JOCRIX/JRIX-KiCad-Schematic-symbols-and-Footprint-libraries/JRIX BGA 3D Models/TFBGA-324_P0.8mm_Body15x15mm.step

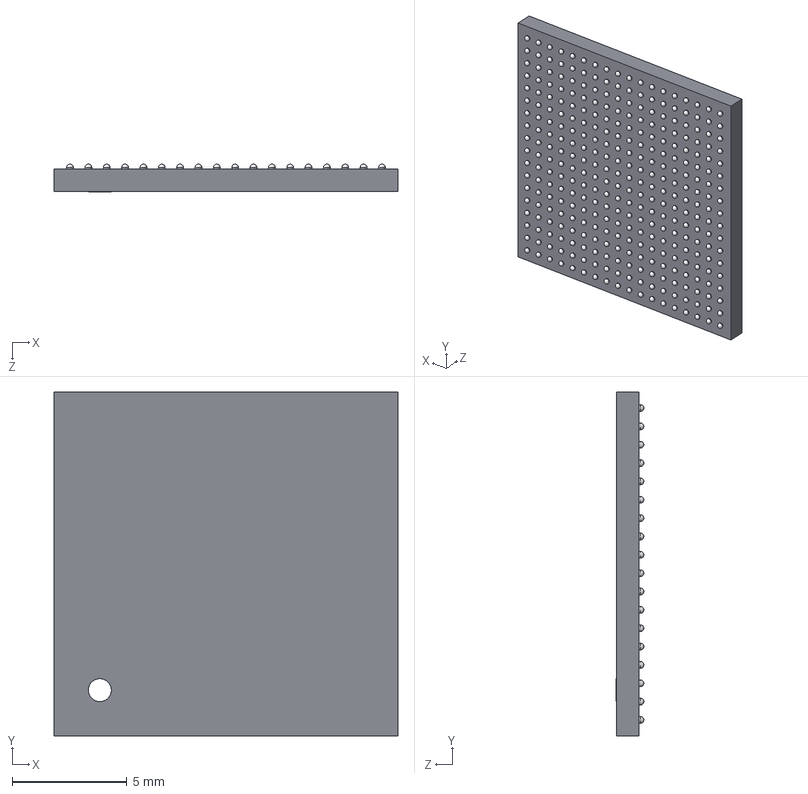
[picture p1: CAD file, 2025-07-26]
JRIX BGA 3D Models/TFBGA-324_P0.8mm_Body15x15mm.step
15.0 x 15.0 x 1.21 mm
Extruded_2
