JOCRIX/JRIX-KiCad-Schematic-symbols-and-Footprint-libraries/JRIX Capacitor SMD 3D Models/C_2x1.25x1.25_GRM21BZ71C106KE15K.stp

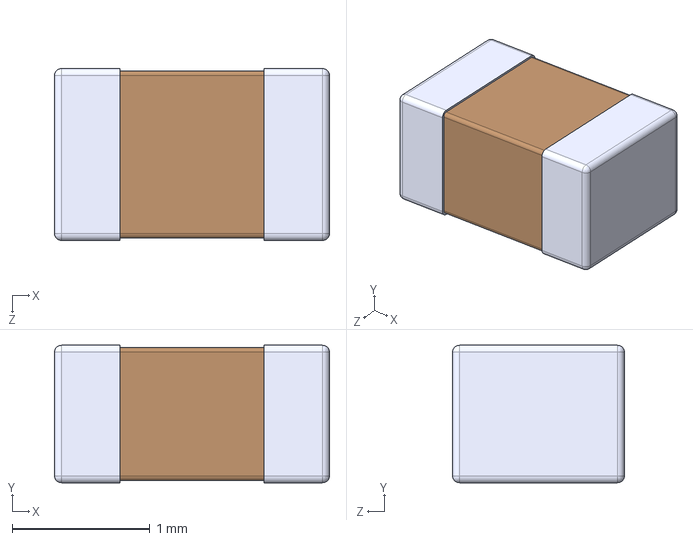
[picture p2: CAD file, 2025-07-29]
JRIX Capacitor SMD 3D Models/C_2x1.25x1.25_GRM21BZ71C106KE15K.stp
2.00 x 1.00 x 1.25 mm
