JOCRIX/JRIX-KiCad-Schematic-symbols-and-Footprint-libraries/JRIX Common-Mode Choke 3D Models/ACM9070-701-2PL-TL01.stp

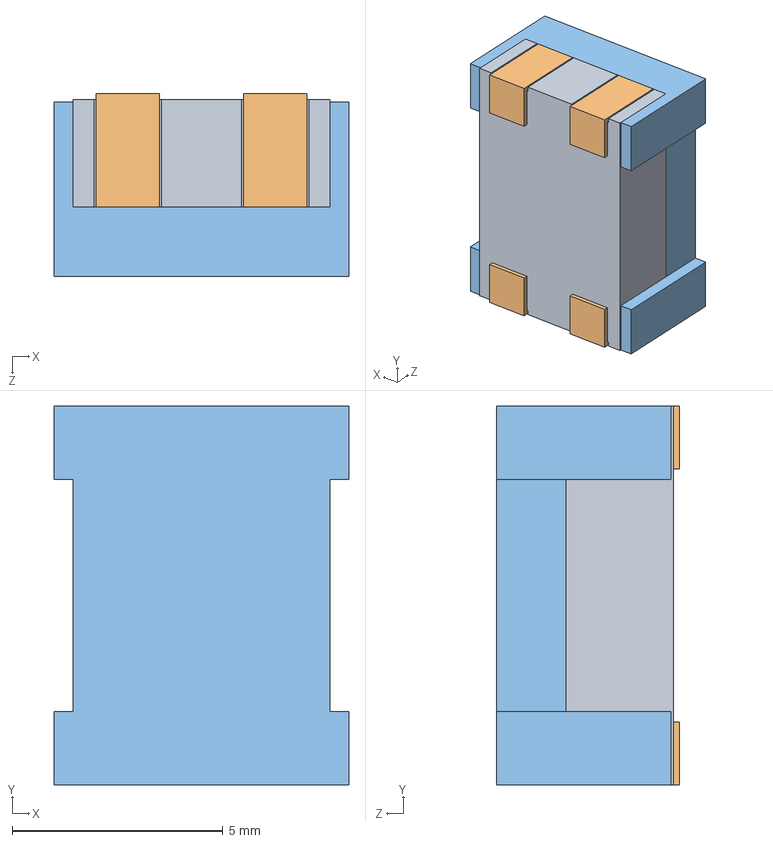
[picture p3: CAD file, 2025-07-09]
JRIX Common-Mode Choke 3D Models/ACM9070-701-2PL-TL01.stp
7.00 x 9.00 x 4.35 mm
ACM90Vコアblock(typ size)
ACM90V端子block(typ size) x 4
ACM90Vカバblock(typ size)
