JOCRIX/JRIX-KiCad-Schematic-symbols-and-Footprint-libraries/JRIX Connector 3D Models/CONBNC001.stp

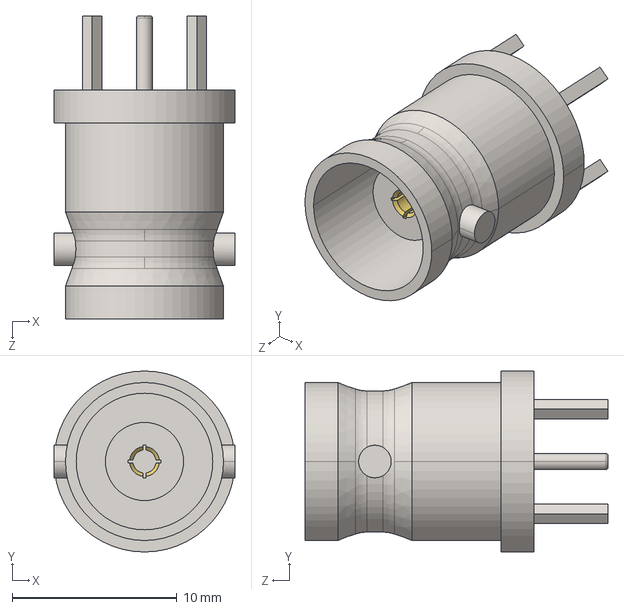
[picture p4: CAD file, 2025-07-27]
JRIX Connector 3D Models/CONBNC001.stp
11.0 x 11.0 x 18.4 mm
