JOCRIX/JRIX-KiCad-Schematic-symbols-and-Footprint-libraries/JRIX DFN SMD 3D Models/22-WFDFN-ExposedPad_22DFN_6x3_AnalogDevices.step

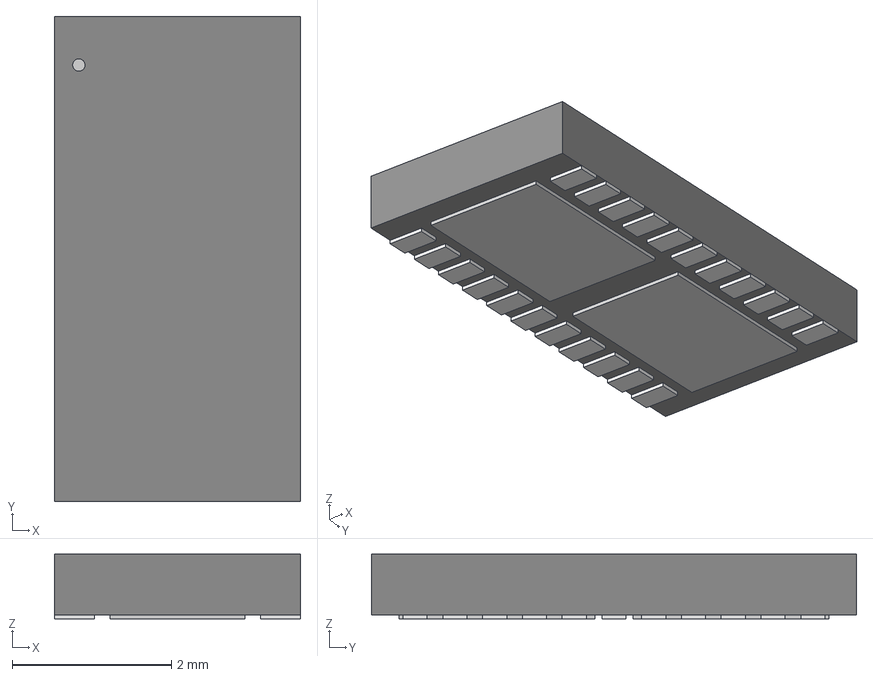
[picture p5: CAD file, 2025-07-28]
JRIX DFN SMD 3D Models/22-WFDFN-ExposedPad_22DFN_6x3_AnalogDevices.step
3.10 x 6.10 x 0.815 mm
