JOCRIX/JRIX-KiCad-Schematic-symbols-and-Footprint-libraries/JRIX Diode 3D Models/infineon-sg-wll-2-11-3d-01-stp-package-en.stp

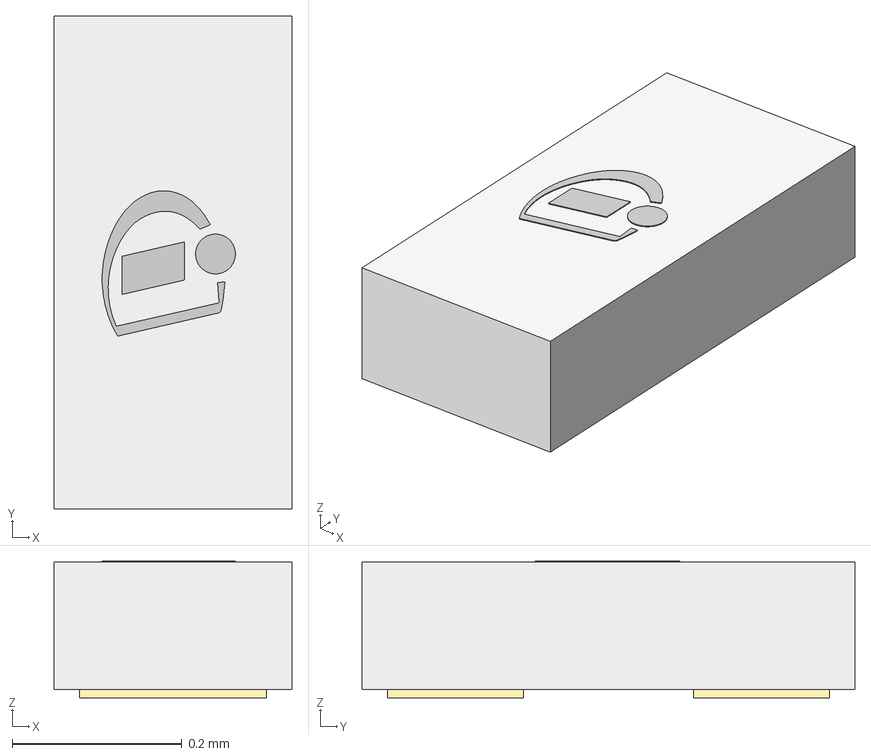
[picture p6: CAD file, 2025-07-27]
JRIX Diode 3D Models/infineon-sg-wll-2-11-3d-01-stp-package-en.stp
0.28 x 0.58 x 0.161 mm
