JOCRIX/JRIX-KiCad-Schematic-symbols-and-Footprint-libraries/JRIX Ferrite Beat 3D Models/FB_0805_2x1.25x0.85_MPZ2012S221AT000.stp

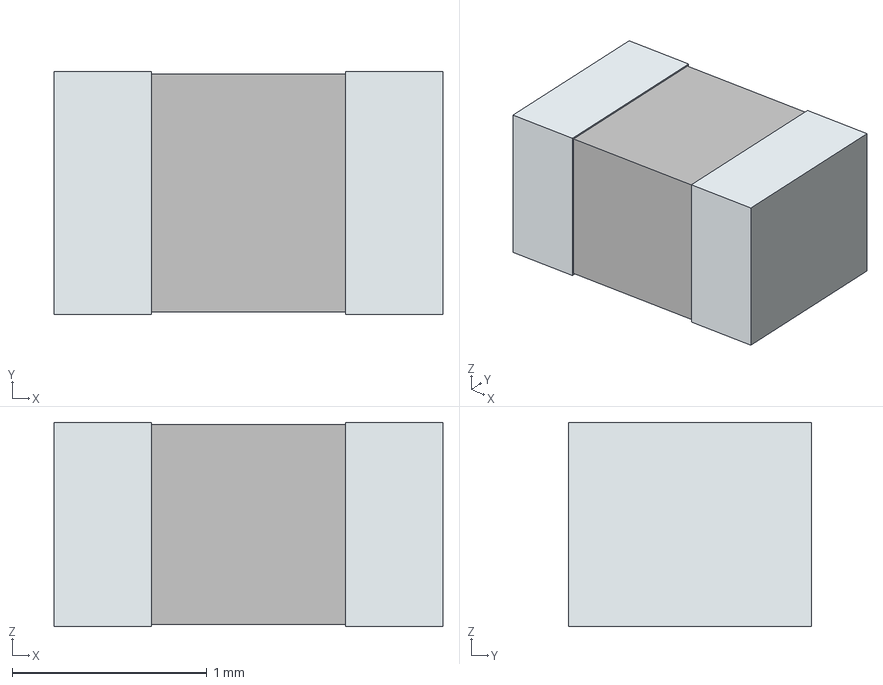
[picture p7: CAD file, 2025-07-13]
JRIX Ferrite Beat 3D Models/FB_0805_2x1.25x0.85_MPZ2012S221AT000.stp
2.00 x 1.25 x 1.05 mm
term1
term2
