JOCRIX/JRIX-KiCad-Schematic-symbols-and-Footprint-libraries/JRIX FPGA 3D Models/CMODS7.step

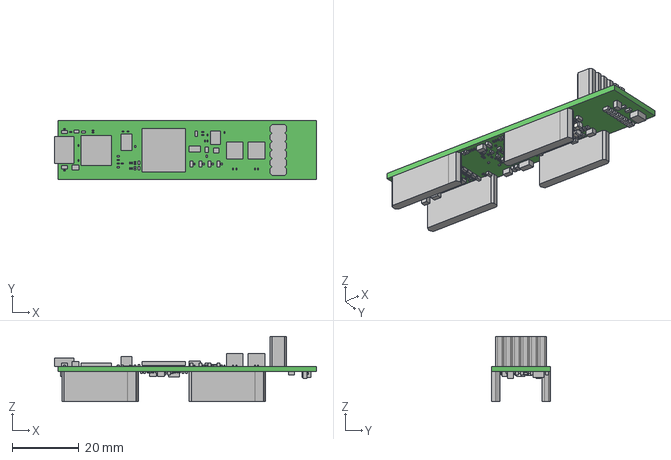
[picture p8: CAD file, 2024-12-05]
JRIX FPGA 3D Models/CMODS7.step
78.4 x 17.8 x 19.6 mm
Board
Extruded x 243
