JOCRIX/JRIX-KiCad-Schematic-symbols-and-Footprint-libraries/JRIX Inductor SMD 3D Models/L_ASPI-4030S-1R0N-T.stp

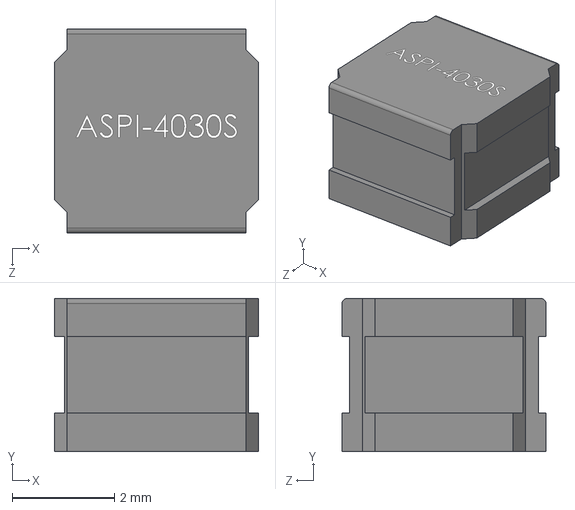
[picture p9: CAD file, 2025-07-11]
JRIX Inductor SMD 3D Models/L_ASPI-4030S-1R0N-T.stp
4.00 x 3.00 x 4.00 mm
