JOCRIX/JRIX-KiCad-Schematic-symbols-and-Footprint-libraries/JRIX Inductor THT 3D Models/AIUR-15-102K.step

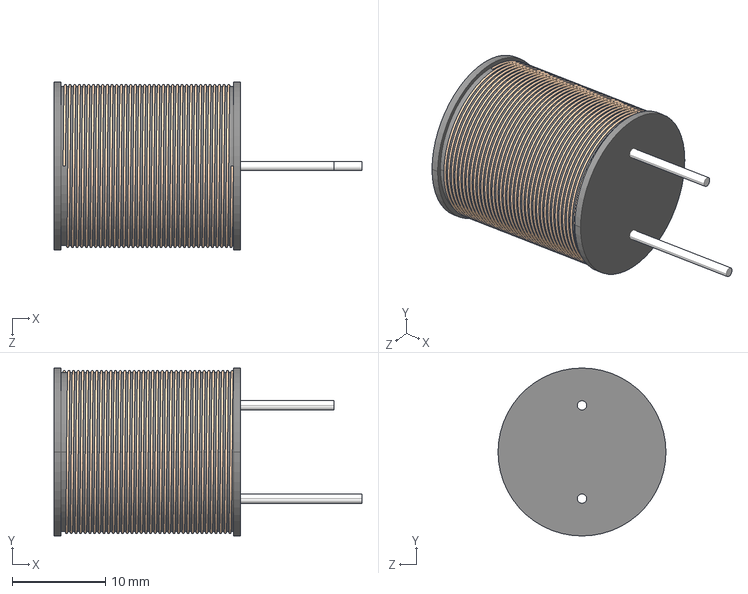
[picture p10: CAD file, 2024-12-03]
JRIX Inductor THT 3D Models/AIUR-15-102K.step
33.0 x 18.0 x 18.0 mm
