JOCRIX/JRIX-KiCad-Schematic-symbols-and-Footprint-libraries/JRIX LED 3D Models/AP1608SURCK.stp

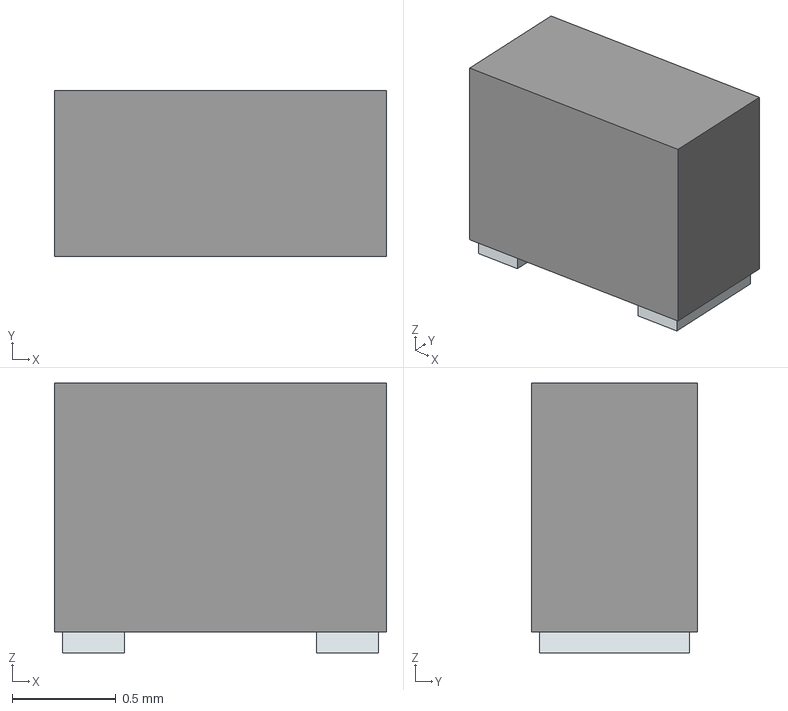
[picture p11: CAD file, 2025-07-08]
JRIX LED 3D Models/AP1608SURCK.stp
1.60 x 0.8 x 1.30 mm
Pins
