JOCRIX/JRIX-KiCad-Schematic-symbols-and-Footprint-libraries/JRIX QFN 3D Models/VFQFN-32_ExposedPad_CSP_32-LFCSP_5x5.step

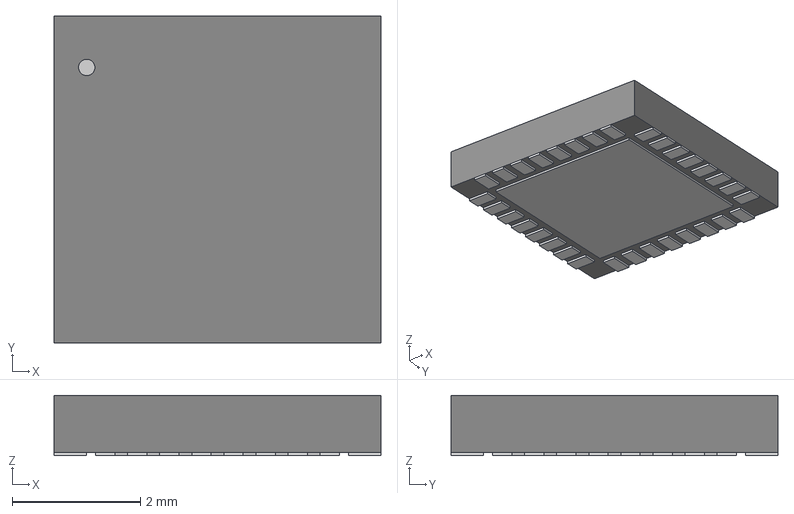
[picture p12: CAD file, 2025-07-28]
JRIX QFN 3D Models/VFQFN-32_ExposedPad_CSP_32-LFCSP_5x5.step
5.11 x 5.11 x 0.942 mm
