JOCRIX/JRIX-KiCad-Schematic-symbols-and-Footprint-libraries/JRIX Relay 3D Models/RY-12W-K.step

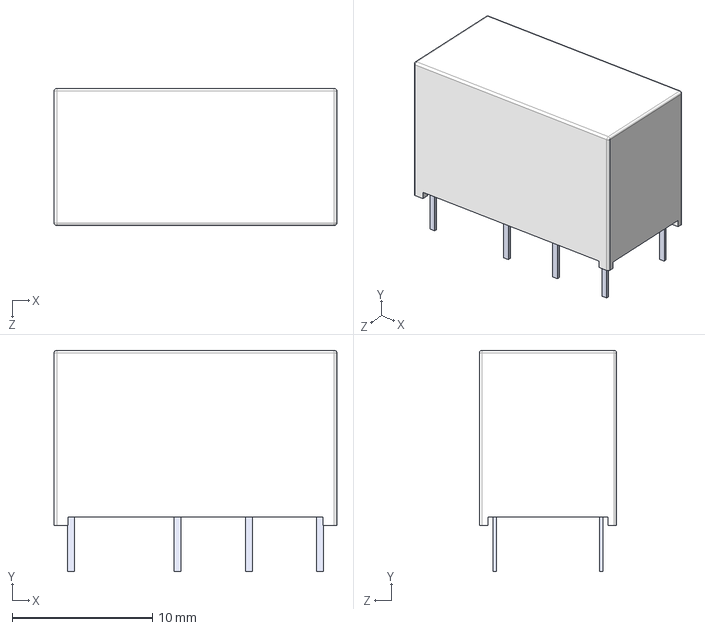
[picture p13: CAD file, 2024-12-03]
JRIX Relay 3D Models/RY-12W-K.step
20.2 x 15.8 x 9.80 mm
