JOCRIX/JRIX-KiCad-Schematic-symbols-and-Footprint-libraries/JRIX Resistor 3D Models/R_ThinFilm_0805_Vishay-MCU.stp

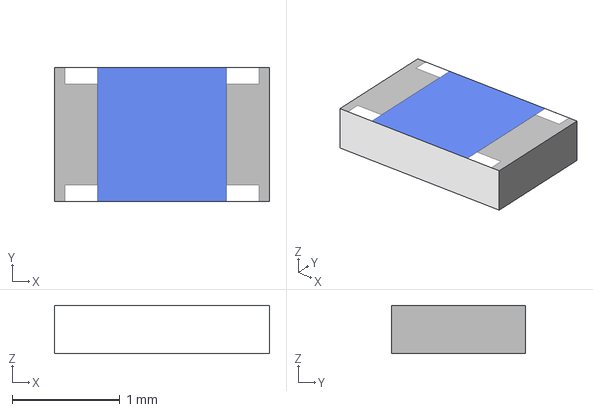
[picture p14: CAD file, 2025-07-27]
JRIX Resistor 3D Models/R_ThinFilm_0805_Vishay-MCU.stp
2.00 x 1.25 x 0.45 mm
