JOCRIX/JRIX-KiCad-Schematic-symbols-and-Footprint-libraries/JRIX SOP 3D Models/SSOP-28_5.3x10.2x1.8.iges

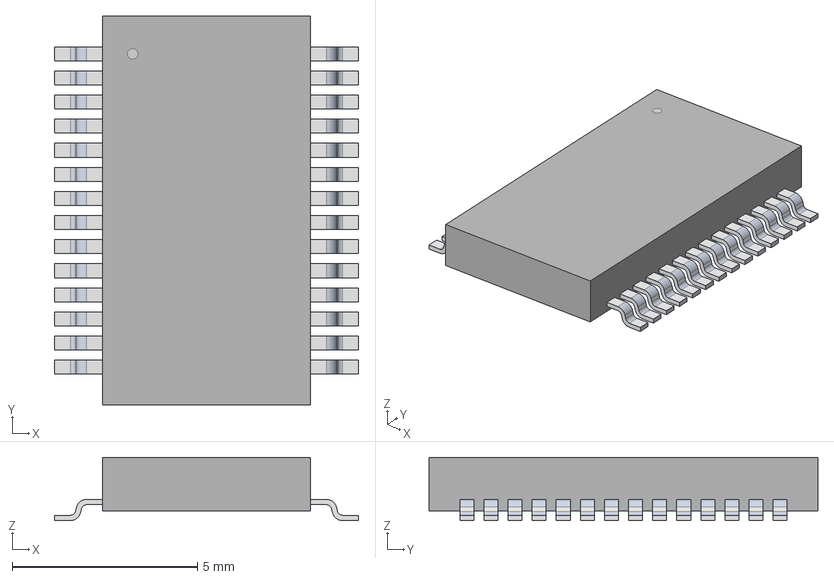
[picture p15: CAD file, 2025-07-29]
JRIX SOP 3D Models/SSOP-28_5.3x10.2x1.8.iges
8.20 x 10.5 x 1.70 mm
