JOCRIX/JRIX-KiCad-Schematic-symbols-and-Footprint-libraries/JRIX SOT SMD 3D Models/SOT-23-5_SC-74A_SOT-753_RJ_5_ADI.step

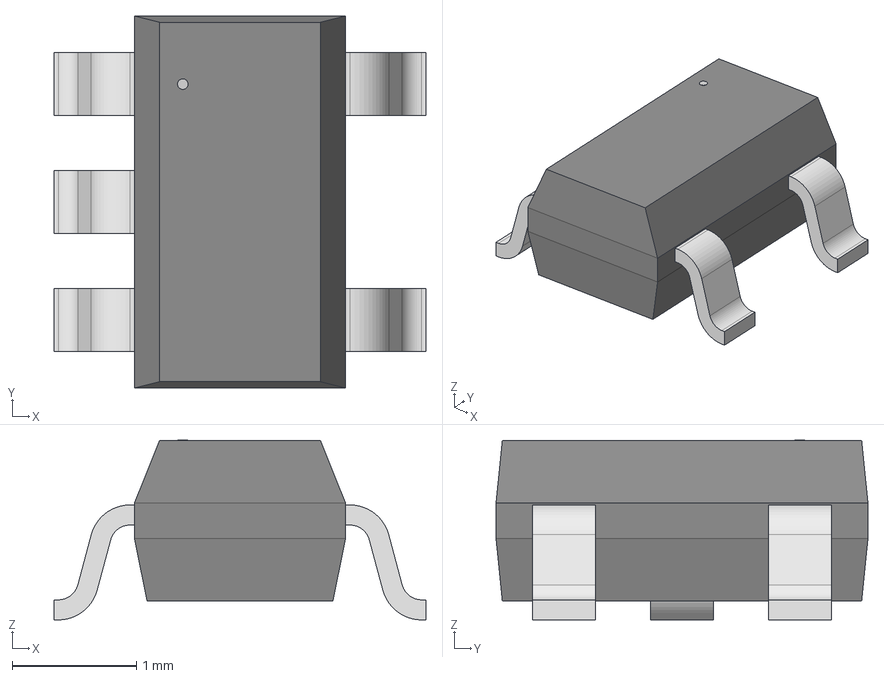
[picture p16: CAD file, 2025-07-29]
JRIX SOT SMD 3D Models/SOT-23-5_SC-74A_SOT-753_RJ_5_ADI.step
3.00 x 3.00 x 1.45 mm
