JOCRIX/JRIX-KiCad-Schematic-symbols-and-Footprint-libraries/JRIX Switches 3D Models/C&K_PTS647-Series_4.5x4.5x7_PTS647SK70SMTR2N_LFS.stp

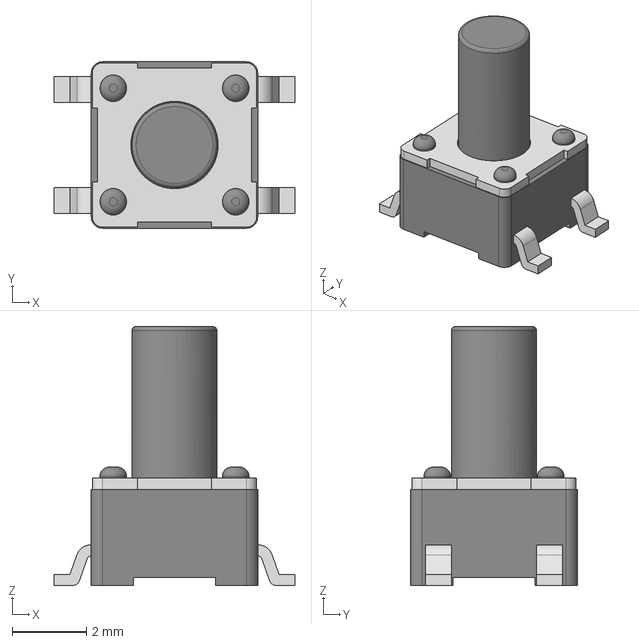
[picture p17: CAD file, 2025-07-27]
JRIX Switches 3D Models/C&K_PTS647-Series_4.5x4.5x7_PTS647SK70SMTR2N_LFS.stp
6.50 x 4.50 x 7.00 mm
