JOCRIX/JRIX-KiCad-Schematic-symbols-and-Footprint-libraries/JRIX Terminal Blocks 3D Models/TB006-508-02BE.STEP

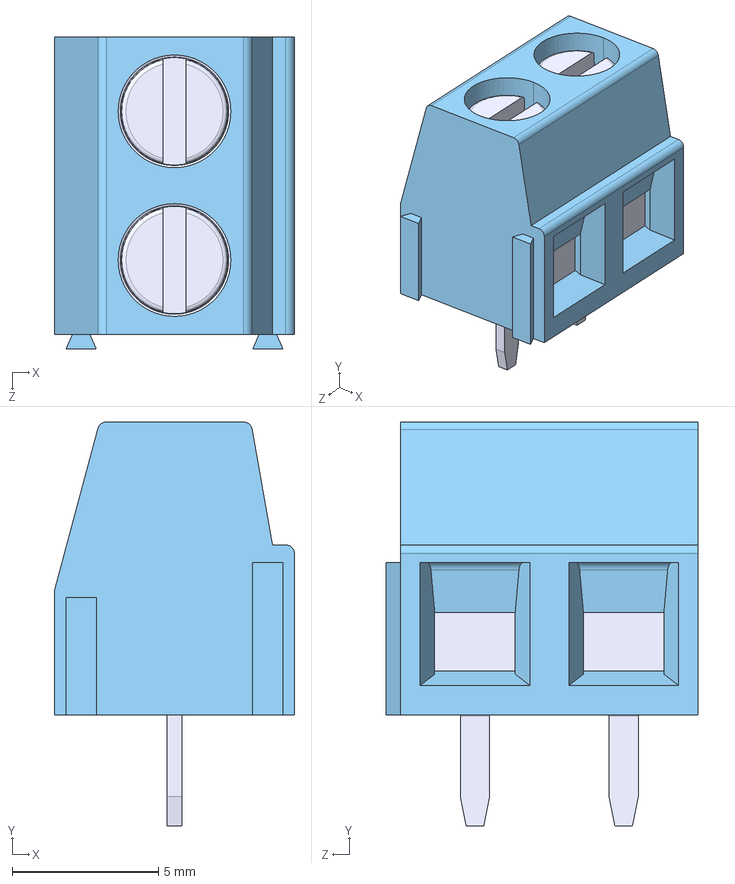
[picture p18: CAD file, 2025-07-27]
JRIX Terminal Blocks 3D Models/TB006-508-02BE.STEP
8.20 x 13.8 x 10.7 mm
