JOCRIX/JRIX-KiCad-Schematic-symbols-and-Footprint-libraries/JRIX XO 3D Models/SIT9501AI-02A1-2510-125.000000.stp

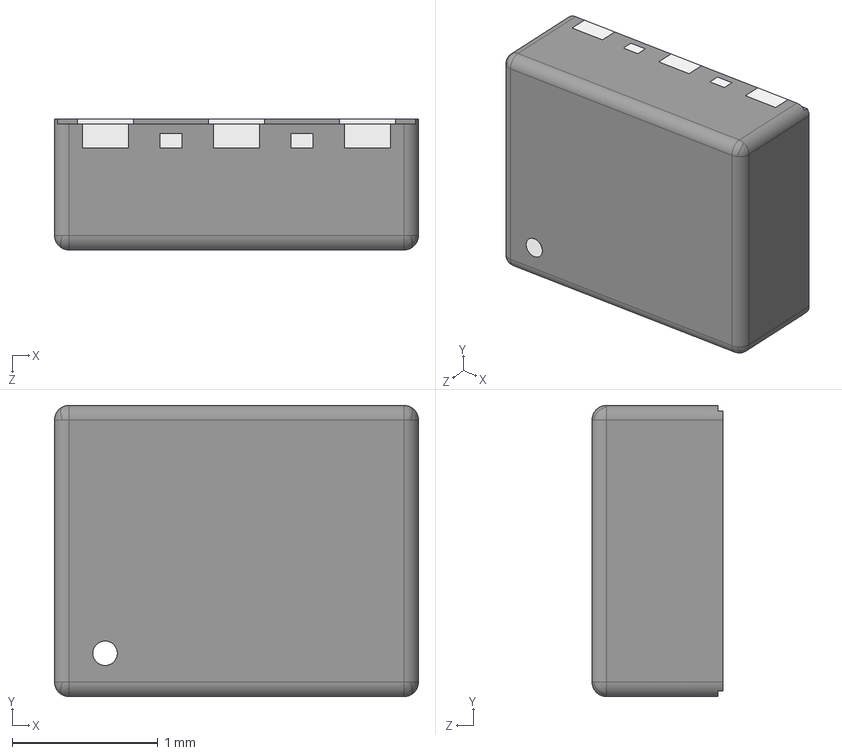
[picture p19: CAD file, 2025-07-08]
JRIX XO 3D Models/SIT9501AI-02A1-2510-125.000000.stp
2.50 x 2.00 x 0.902 mm
