JOCRIX/JRIX-KiCad-Schematic-symbols-and-Footprint-libraries/JRIX BGA 3D Models/FBGA-48_6x10_Layout-6x8_P0.75_AS7CW2M16-10BIN.stp

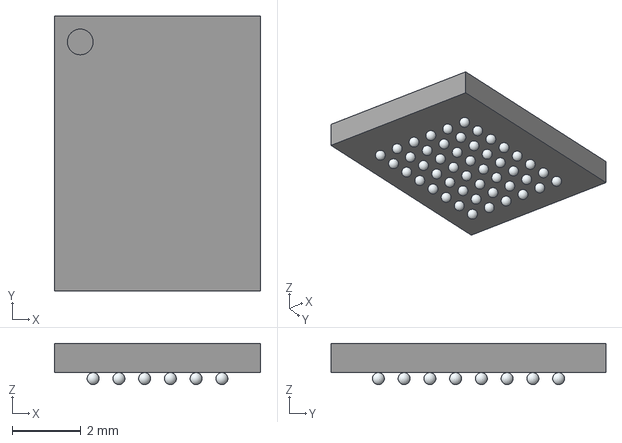
[picture p20: CAD file, 2025-07-26]
JRIX BGA 3D Models/FBGA-48_6x10_Layout-6x8_P0.75_AS7CW2M16-10BIN.stp
6.00 x 8.00 x 1.20 mm
