JOCRIX/JRIX-KiCad-Schematic-symbols-and-Footprint-libraries/JRIX Capacitor SMD 3D Models/C_1x0.5x0.5604023A1R2BAT2A.stp

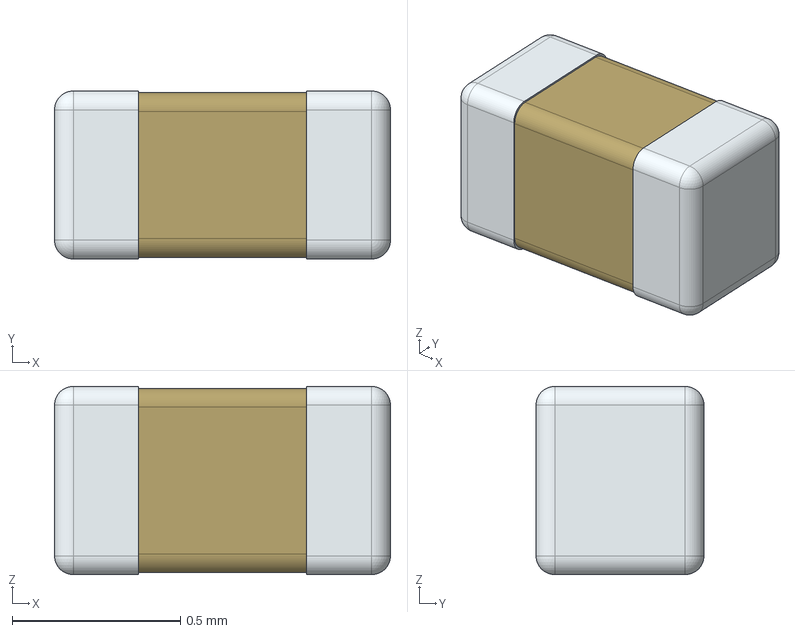
[picture p21: CAD file, 2025-07-29]
JRIX Capacitor SMD 3D Models/C_1x0.5x0.5604023A1R2BAT2A.stp
1.00 x 0.5 x 0.56 mm
