JOCRIX/JRIX-KiCad-Schematic-symbols-and-Footprint-libraries/JRIX DFN SMD 3D Models/DFN-10_LT3042EDD#PBF.stp

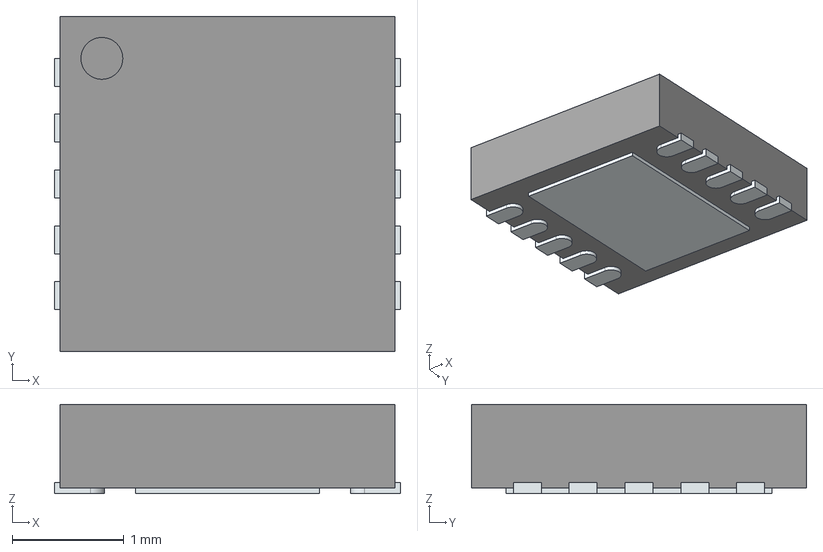
[picture p22: CAD file, 2025-07-13]
JRIX DFN SMD 3D Models/DFN-10_LT3042EDD#PBF.stp
3.10 x 3.00 x 0.8 mm
ThermalPin
PinsArrayLR
