JOCRIX/JRIX-KiCad-Schematic-symbols-and-Footprint-libraries/JRIX Diode 3D Models/SOD-882L_CFSH05-20L_TR_PBFREE.stp

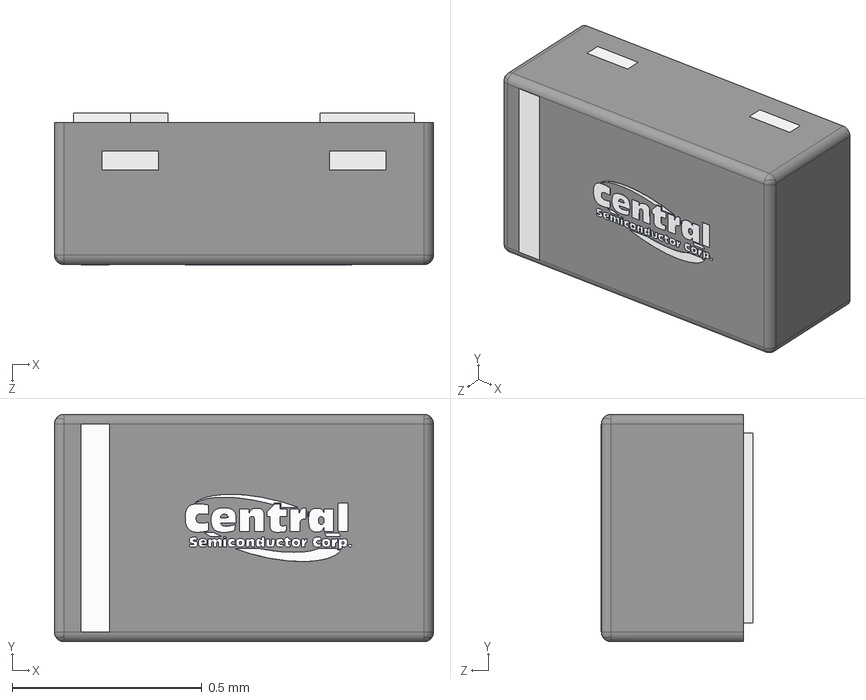
[picture p23: CAD file, 2025-07-09]
JRIX Diode 3D Models/SOD-882L_CFSH05-20L_TR_PBFREE.stp
1.00 x 0.6 x 0.401 mm
Package
Pads
Band
Logo
