JOCRIX/JRIX-KiCad-Schematic-symbols-and-Footprint-libraries/JRIX QFN 3D Models/QFN-14_TLV9064IRUCR.stp

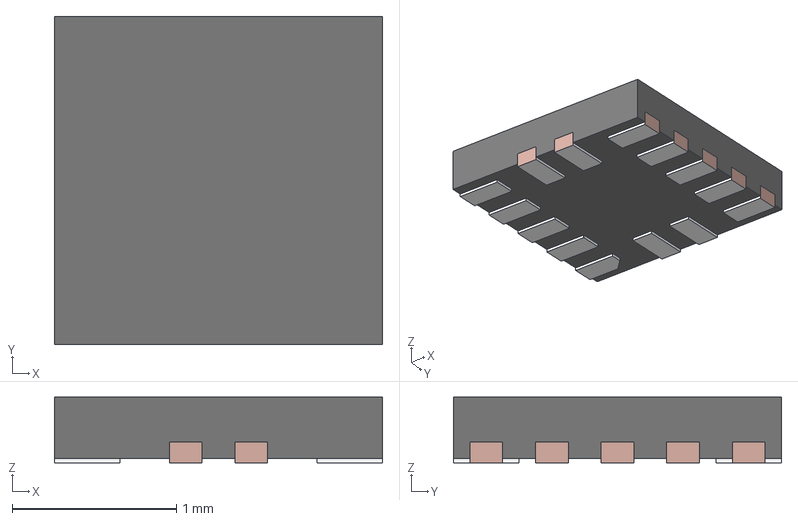
[picture p24: CAD file, 2025-07-27]
JRIX QFN 3D Models/QFN-14_TLV9064IRUCR.stp
2.00 x 2.00 x 0.4 mm
FRAME
