JOCRIX/JRIX-KiCad-Schematic-symbols-and-Footprint-libraries/JRIX Resistor 3D Models/R_ThinFilm_1x0.5x0.35_0402_TNPW040249K9BYEP.step

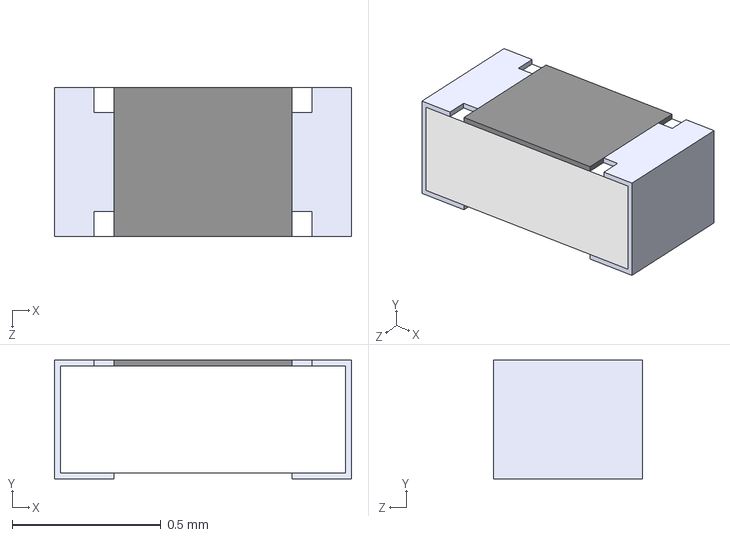
[picture p25: CAD file, 2025-07-27]
JRIX Resistor 3D Models/R_ThinFilm_1x0.5x0.35_0402_TNPW040249K9BYEP.step
1 x 0.4 x 0.5 mm
