JOCRIX/JRIX-KiCad-Schematic-symbols-and-Footprint-libraries/JRIX SOT SMD 3D Models/SOT-563-6_DRL0006A_1.6x1.2x0.6_Texas_Instruments.stp

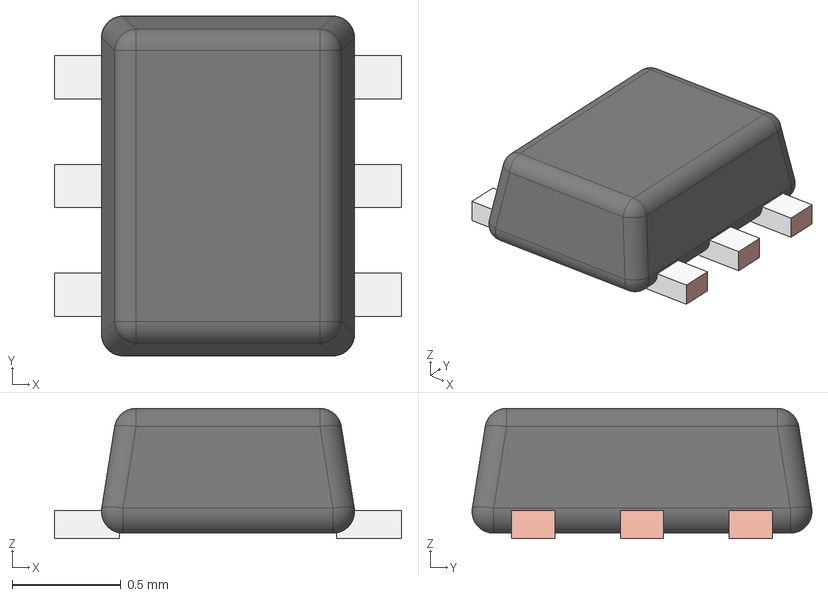
[picture p26: CAD file, 2025-07-09]
JRIX SOT SMD 3D Models/SOT-563-6_DRL0006A_1.6x1.2x0.6_Texas_Instruments.stp
1.60 x 1.57 x 0.6 mm
FRAME-DRL0006A
BODY-SOT
PIN1-ID
