JOCRIX/JRIX-KiCad-Schematic-symbols-and-Footprint-libraries/JRIX Capacitor SMD 3D Models/C_1.6x0.81x0.9_0603_1608_06035A250GAT2A.stp

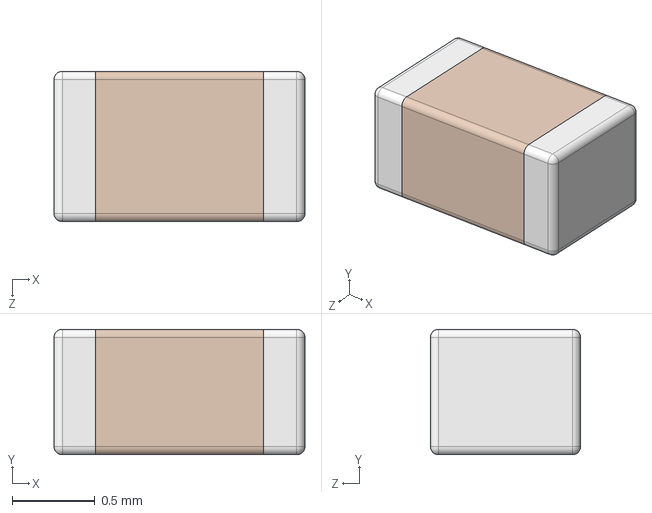
[picture p27: CAD file, 2025-07-28]
JRIX Capacitor SMD 3D Models/C_1.6x0.81x0.9_0603_1608_06035A250GAT2A.stp
1.52 x 0.76 x 0.91 mm
