JOCRIX/JRIX-KiCad-Schematic-symbols-and-Footprint-libraries/JRIX DFN SMD 3D Models/20-UDFDN_20-USON_TXB0108DQSR_4x2x0.5_Texas-Instruments.STEP

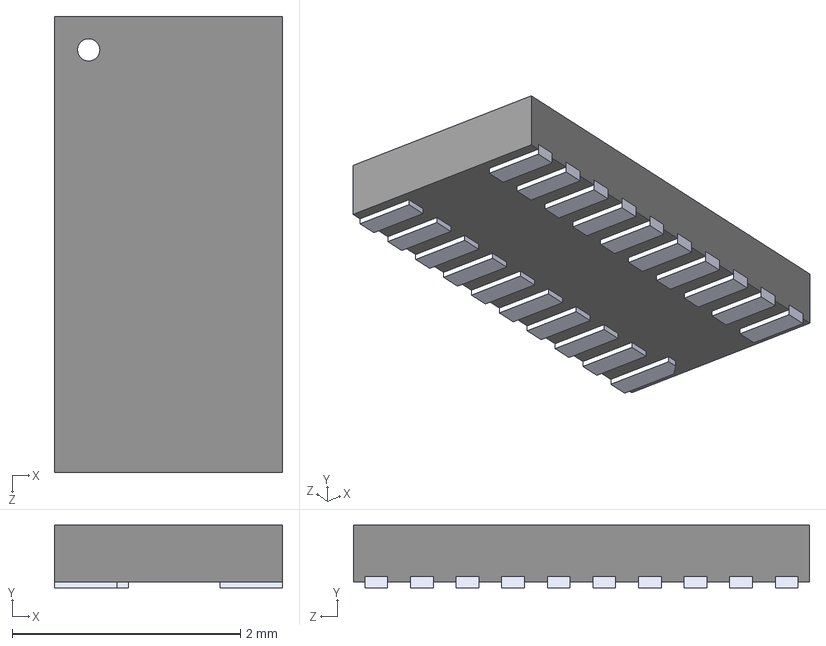
[picture p28: CAD file, 2025-07-09]
JRIX DFN SMD 3D Models/20-UDFDN_20-USON_TXB0108DQSR_4x2x0.5_Texas-Instruments.STEP
2.00 x 0.55 x 4.00 mm
