JOCRIX/JRIX-KiCad-Schematic-symbols-and-Footprint-libraries/JRIX Resistor 3D Models/R_ThinFilm_0402_Vishay-MCS.stp

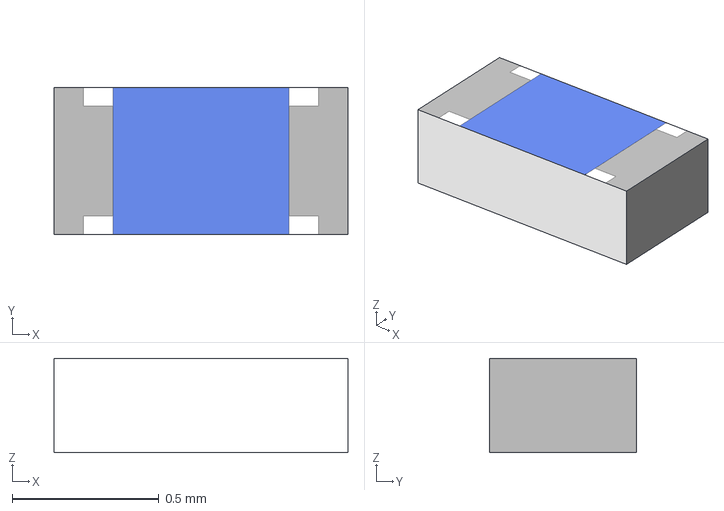
[picture p29: CAD file, 2025-07-27]
JRIX Resistor 3D Models/R_ThinFilm_0402_Vishay-MCS.stp
1.00 x 0.5 x 0.32 mm
