JOCRIX/JRIX-KiCad-Schematic-symbols-and-Footprint-libraries/JRIX SOT SMD 3D Models/SOT-553-5_SOT-5_Texas_Instruments_1.6x1.2x0.6.stp

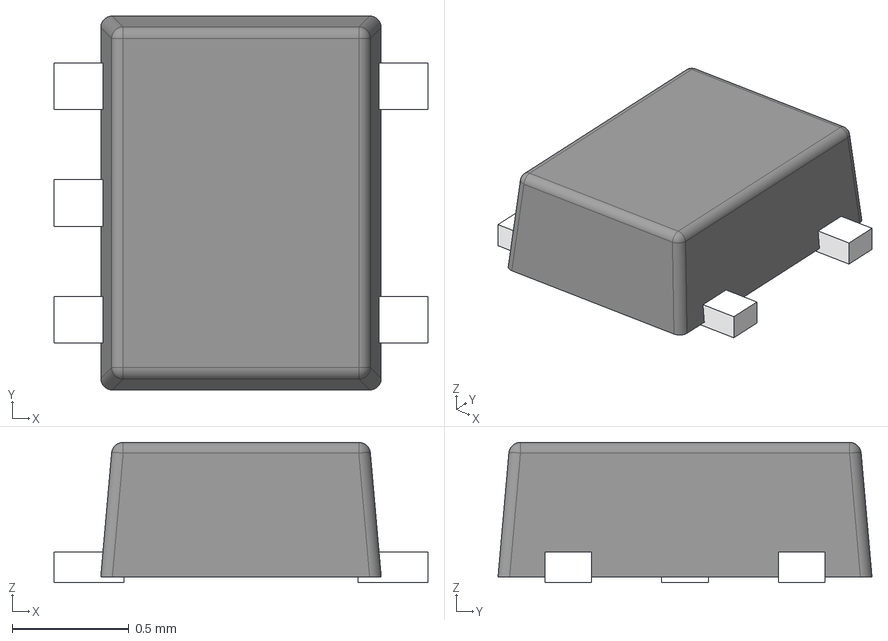
[picture p30: CAD file, 2025-07-09]
JRIX SOT SMD 3D Models/SOT-553-5_SOT-5_Texas_Instruments_1.6x1.2x0.6.stp
1.60 x 1.60 x 0.6 mm
FRAME-DRL0005A
BODY-SOT
PIN1-ID
