JOCRIX/JRIX-KiCad-Schematic-symbols-and-Footprint-libraries/JRIX QFN 3D Models/LTC2270IUP#PBF.stp

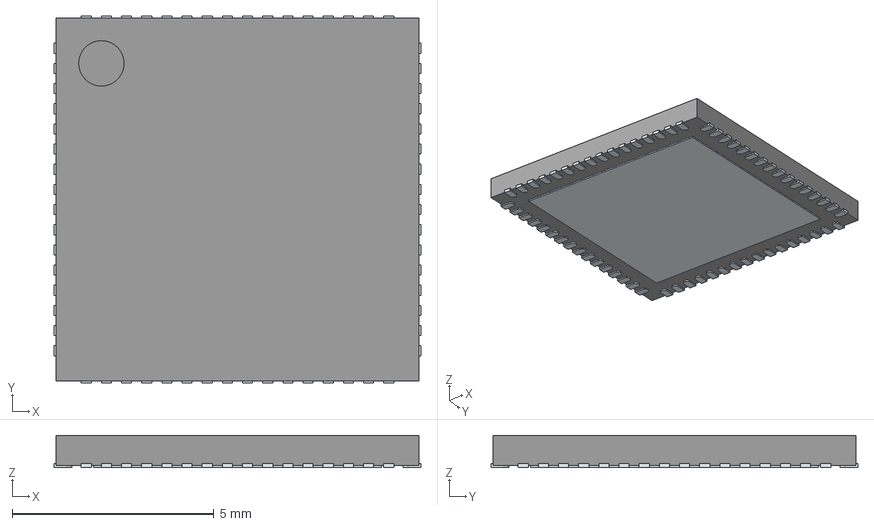
[picture p31: CAD file, 2025-07-13]
JRIX QFN 3D Models/LTC2270IUP#PBF.stp
9.10 x 9.10 x 0.8 mm
ThermalPin
PinsArrayLR
PinsArrayTB
