JOCRIX/JRIX-KiCad-Schematic-symbols-and-Footprint-libraries/JRIX Resistor 3D Models/R_ThinFilm_1206_Vishay-MCA.stp

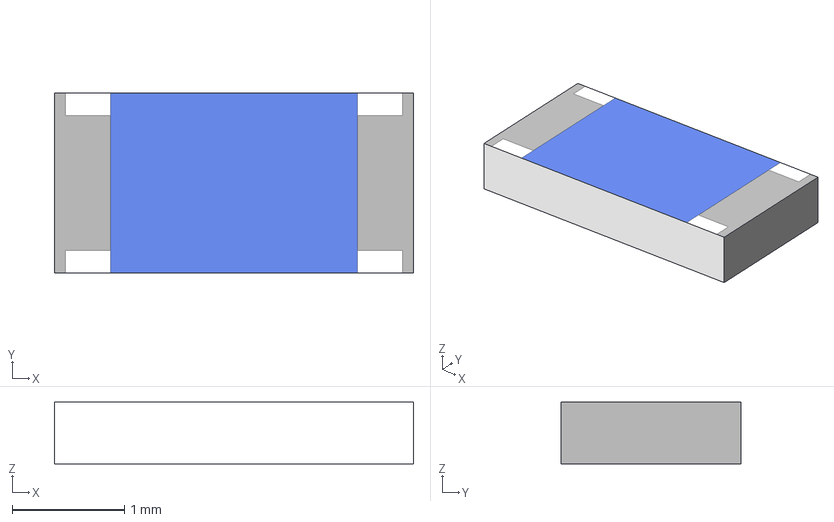
[picture p32: CAD file, 2025-07-27]
JRIX Resistor 3D Models/R_ThinFilm_1206_Vishay-MCA.stp
3.20 x 1.60 x 0.55 mm
