JOCRIX/JRIX-KiCad-Schematic-symbols-and-Footprint-libraries/JRIX Capacitor SMD 3D Models/C_Film_3.2x1.6x1.2_1206_MU_13216_RUB.step

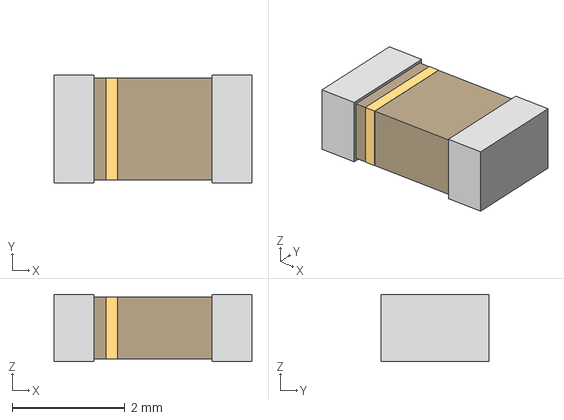
[picture p33: CAD file, 2025-07-26]
JRIX Capacitor SMD 3D Models/C_Film_3.2x1.6x1.2_1206_MU_13216_RUB.step
3.51 x 1.90 x 1.19 mm
