JOCRIX/JRIX-KiCad-Schematic-symbols-and-Footprint-libraries/JRIX Resistor 3D Models/R_ThinFilm_0603_Vishay-MCT.stp

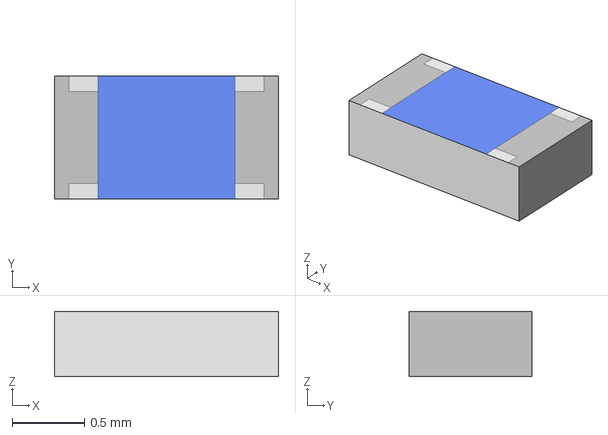
[picture p34: CAD file, 2025-07-27]
JRIX Resistor 3D Models/R_ThinFilm_0603_Vishay-MCT.stp
1.55 x 0.85 x 0.45 mm
