JOCRIX/JRIX-KiCad-Schematic-symbols-and-Footprint-libraries/JRIX Capacitor SMD 3D Models/C_IDC_0508_2.03x1.27_W2L14Z225MAT1S.stp

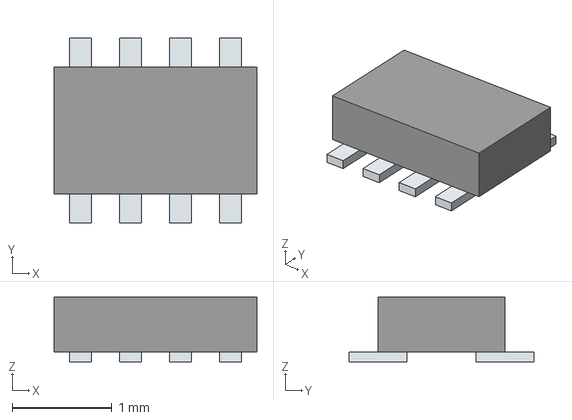
[picture p35: CAD file, 2025-07-13]
JRIX Capacitor SMD 3D Models/C_IDC_0508_2.03x1.27_W2L14Z225MAT1S.stp
2.03 x 1.85 x 0.65 mm
Pins
