JOCRIX/JRIX-KiCad-Schematic-symbols-and-Footprint-libraries/JRIX Resistor 3D Models/R_MELF_0204_3.6x1.4__MMx-precision-series_MMA02040E5002BB300.stp

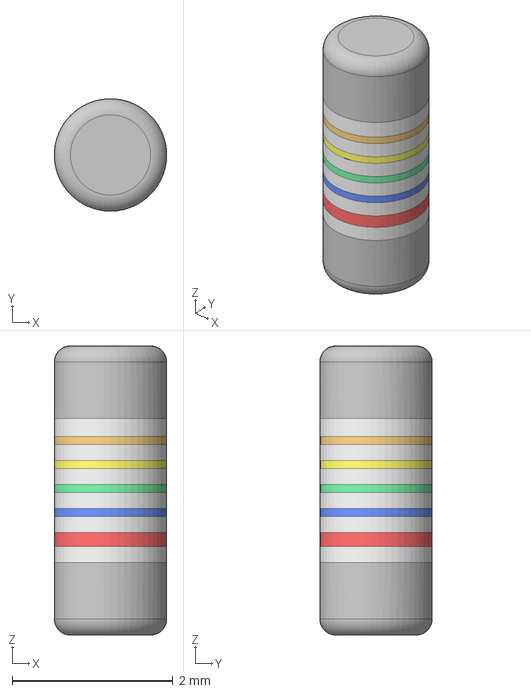
[picture p36: CAD file, 2025-07-26]
JRIX Resistor 3D Models/R_MELF_0204_3.6x1.4__MMx-precision-series_MMA02040E5002BB300.stp
1.40 x 1.40 x 3.60 mm
