JOCRIX/JRIX-KiCad-Schematic-symbols-and-Footprint-libraries/JRIX Capacitor SMD 3D Models/C_GRM31C5C1E474JE01L.stp

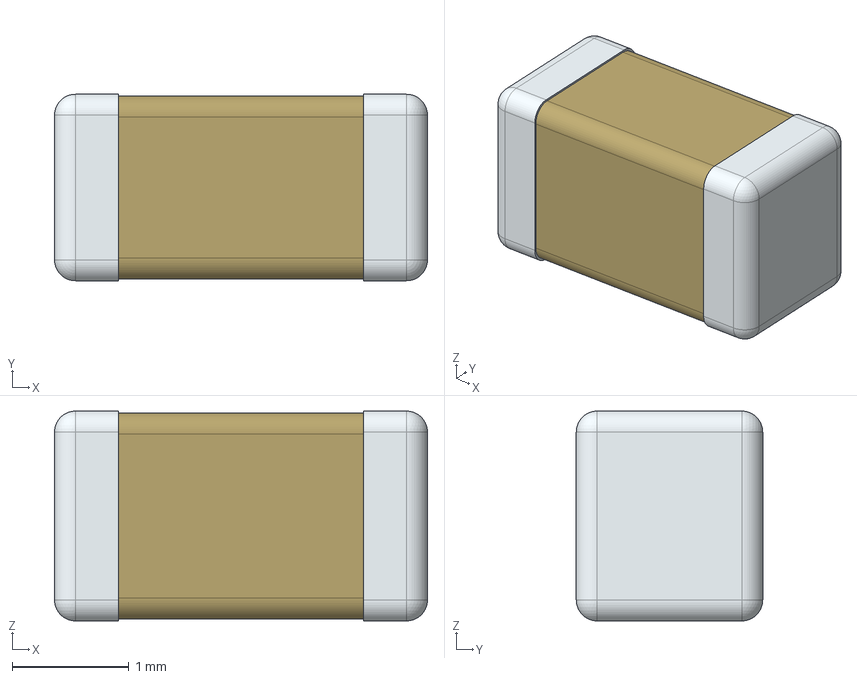
[picture p37: CAD file, 2025-07-13]
JRIX Capacitor SMD 3D Models/C_GRM31C5C1E474JE01L.stp
3.20 x 1.60 x 1.80 mm
