JOCRIX/JRIX-KiCad-Schematic-symbols-and-Footprint-libraries/JRIX Capacitor SMD 3D Models/C_GRM155Z71A225KE01D.stp

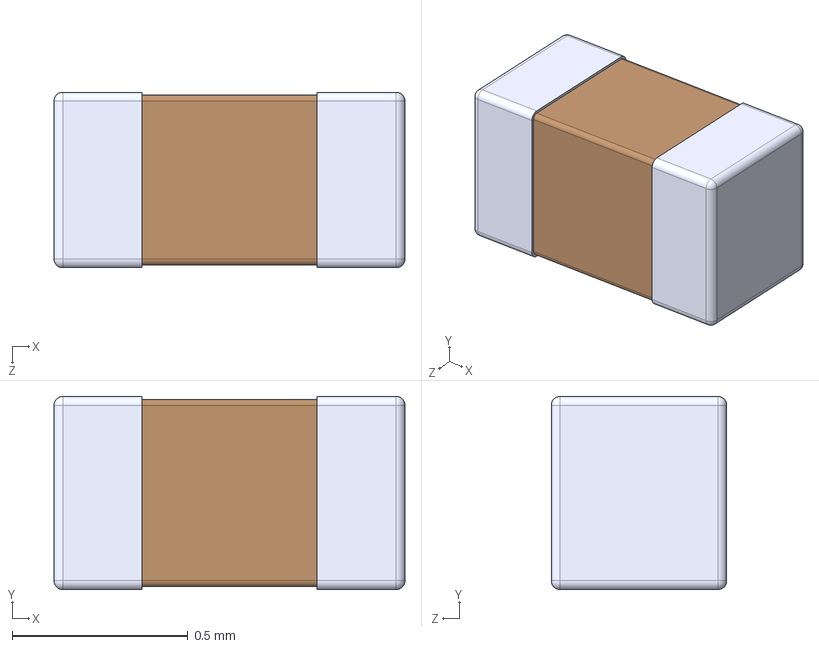
[picture p38: CAD file, 2025-07-11]
JRIX Capacitor SMD 3D Models/C_GRM155Z71A225KE01D.stp
1.00 x 0.55 x 0.5 mm
