JOCRIX/JRIX-KiCad-Schematic-symbols-and-Footprint-libraries/JRIX Capacitor SMD 3D Models/C_GRM31CR60J107KEA8L.stp

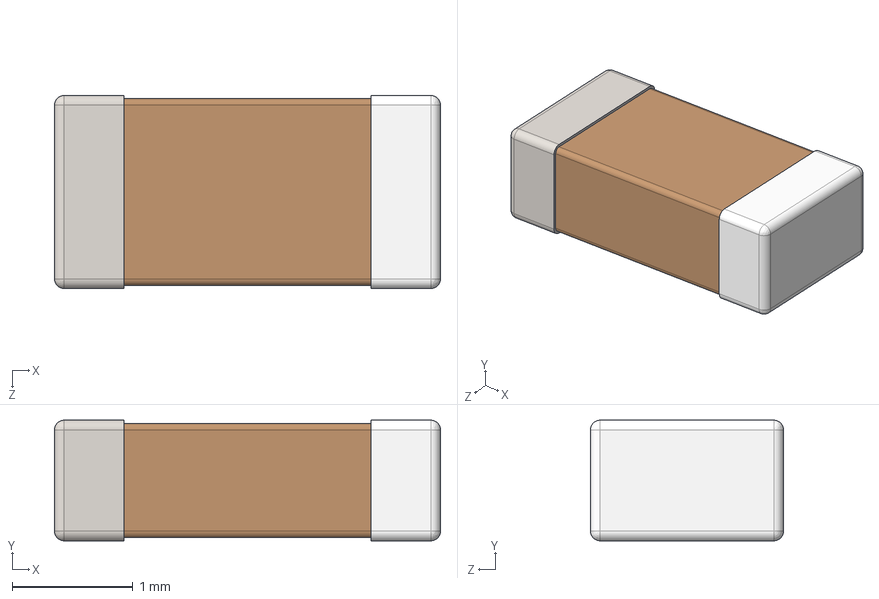
[picture p39: CAD file, 2025-07-09]
JRIX Capacitor SMD 3D Models/C_GRM31CR60J107KEA8L.stp
3.20 x 1 x 1.60 mm
GCM31A5C2J820JX01J_3
GCM31A5C2J820JX01J_2
GCM31A5C2J820JX01J
