JOCRIX/JRIX-KiCad-Schematic-symbols-and-Footprint-libraries/JRIX Capacitor SMD 3D Models/C_GCM155R72A102KA37J.stp

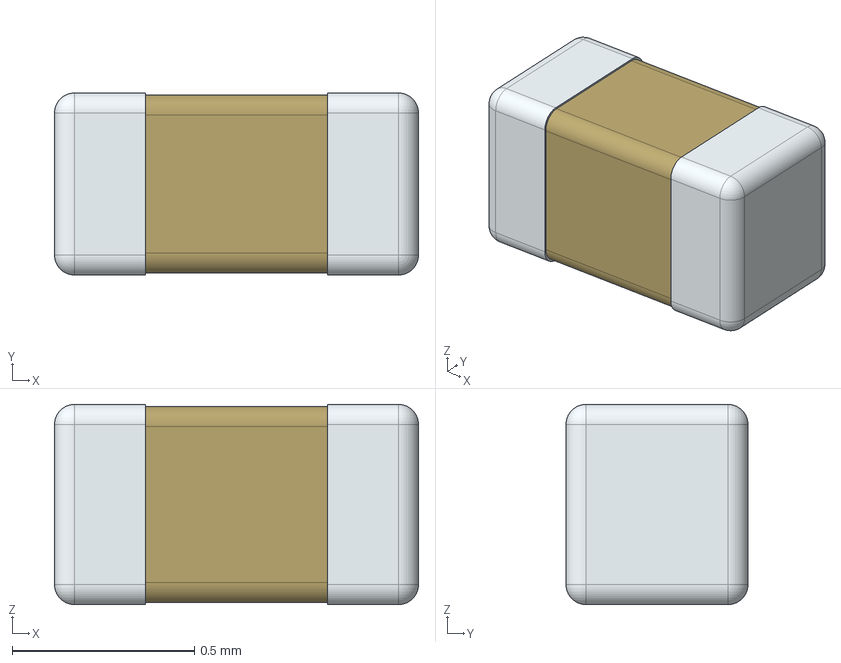
[picture p40: CAD file, 2025-07-09]
JRIX Capacitor SMD 3D Models/C_GCM155R72A102KA37J.stp
1.00 x 0.5 x 0.55 mm
