JOCRIX/JRIX-KiCad-Schematic-symbols-and-Footprint-libraries/JRIX Capacitor SMD 3D Models/C_GRM188Z71A475KE15D.stp

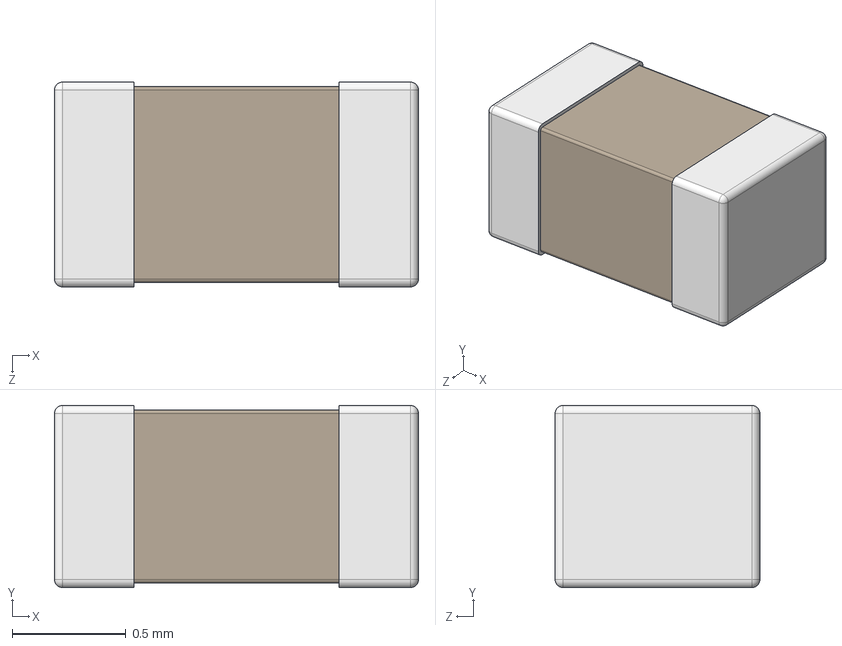
[picture p41: CAD file, 2025-07-09]
JRIX Capacitor SMD 3D Models/C_GRM188Z71A475KE15D.stp
1.60 x 0.8 x 0.9 mm
