JOCRIX/JRIX-KiCad-Schematic-symbols-and-Footprint-libraries/JRIX Capacitor SMD 3D Models/C_GRMJN65C1H104GE01J.stp

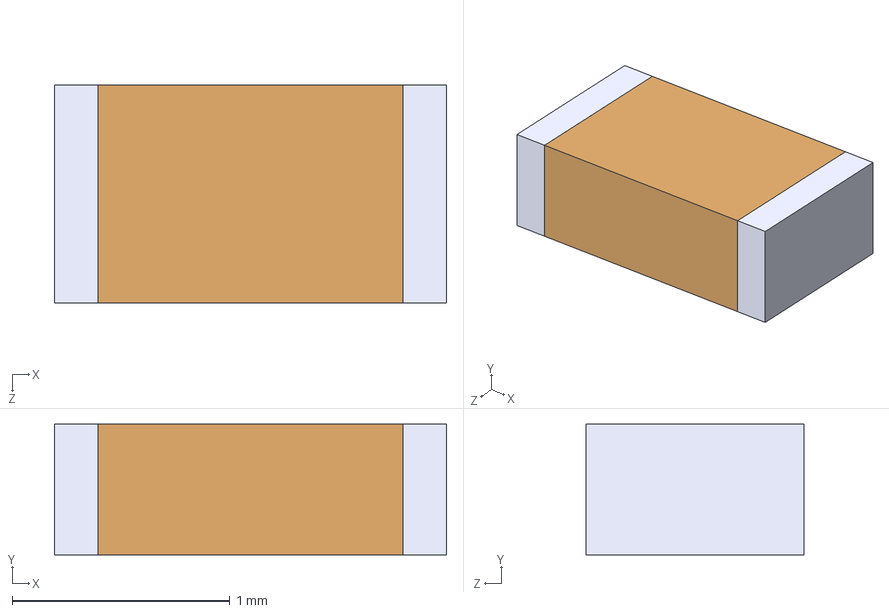
[picture p42: CAD file, 2025-07-09]
JRIX Capacitor SMD 3D Models/C_GRMJN65C1H104GE01J.stp
1.80 x 0.6 x 1.00 mm
