JOCRIX/JRIX-KiCad-Schematic-symbols-and-Footprint-libraries/JRIX Capacitor SMD 3D Models/CP_Elec_6.3x7.7.step

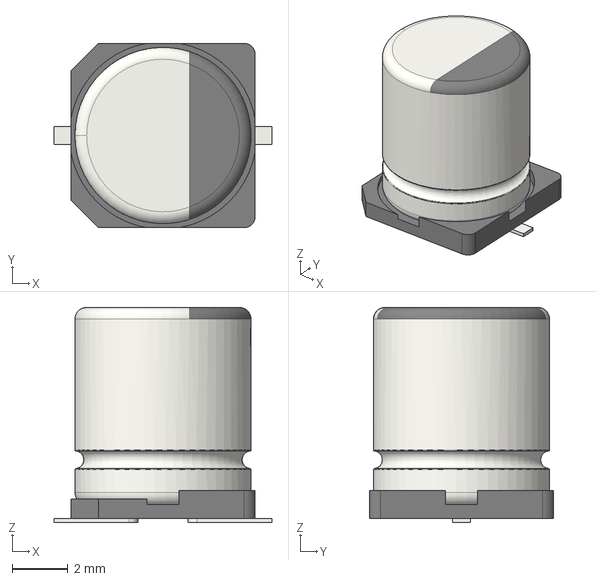
[picture p48: CAD file, 2025-07-09]
JRIX Capacitor SMD 3D Models/CP_Elec_6.3x7.7.step
7.80 x 6.60 x 7.70 mm
