JOCRIX/JRIX-KiCad-Schematic-symbols-and-Footprint-libraries/JRIX Capacitor SMD 3D Models/CP_Elec_6.3x3.9.step

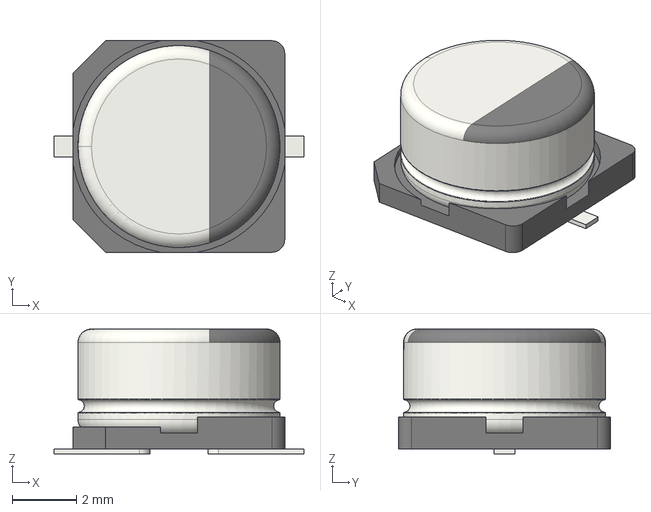
[picture p49: CAD file, 2025-07-09]
JRIX Capacitor SMD 3D Models/CP_Elec_6.3x3.9.step
7.80 x 6.60 x 3.90 mm
