JOCRIX/JRIX-KiCad-Schematic-symbols-and-Footprint-libraries/JRIX Capacitor SMD 3D Models/C_Trimmer_Voltronics_JR.step

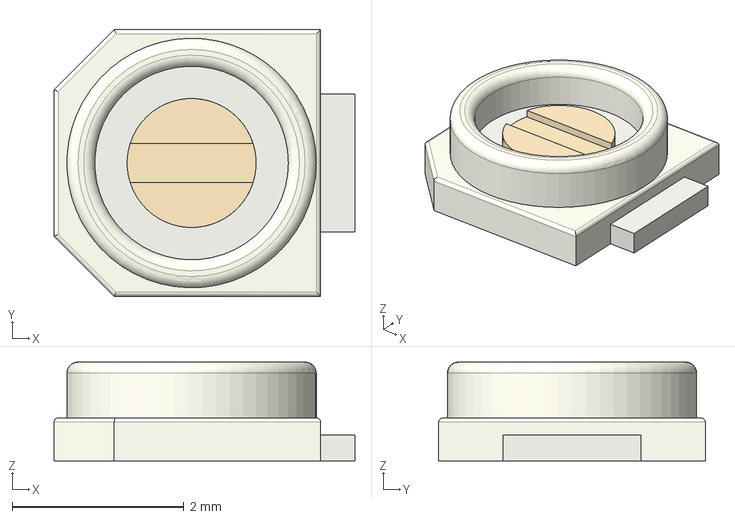
[picture p50: CAD file, 2025-07-09]
JRIX Capacitor SMD 3D Models/C_Trimmer_Voltronics_JR.step
3.50 x 3.10 x 1.15 mm
