JOCRIX/JRIX-KiCad-Schematic-symbols-and-Footprint-libraries/JRIX Capacitor SMD 3D Models/CP_Elec_3x5.4.step

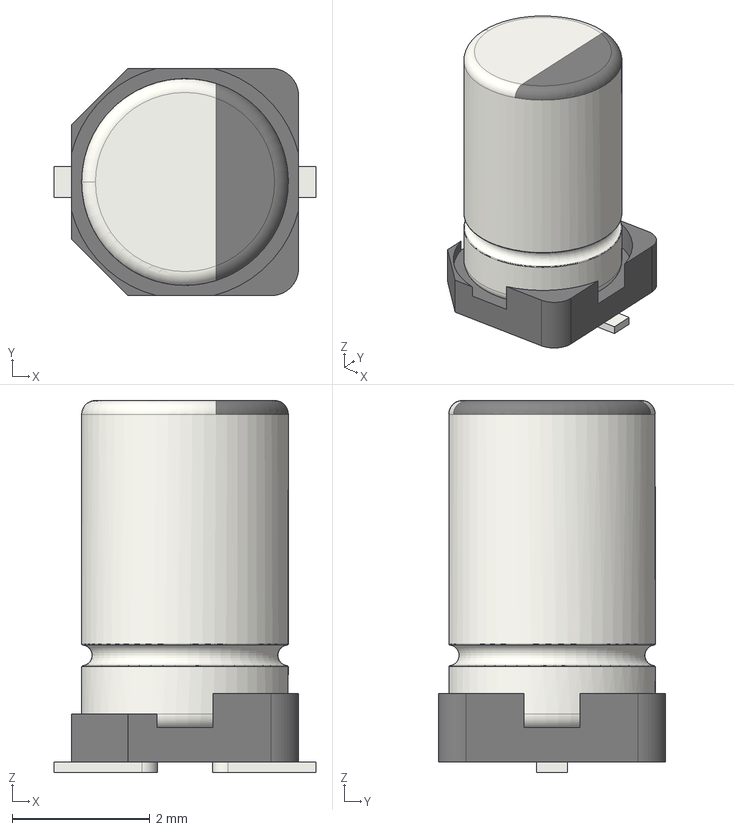
[picture p52: CAD file, 2025-07-09]
JRIX Capacitor SMD 3D Models/CP_Elec_3x5.4.step
3.80 x 3.30 x 5.40 mm
