JOCRIX/JRIX-KiCad-Schematic-symbols-and-Footprint-libraries/JRIX Capacitor SMD 3D Models/CP_Elec_18x22.step

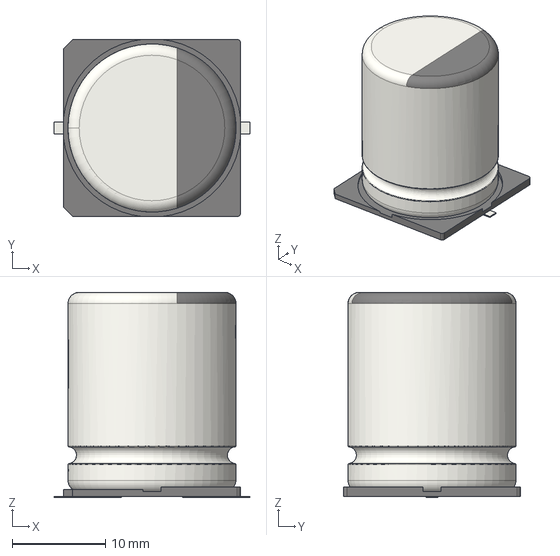
[picture p57: CAD file, 2025-07-09]
JRIX Capacitor SMD 3D Models/CP_Elec_18x22.step
21.0 x 19.0 x 22.0 mm
