JOCRIX/JRIX-KiCad-Schematic-symbols-and-Footprint-libraries/JRIX Capacitor SMD 3D Models/C_1812_4532Metric.step

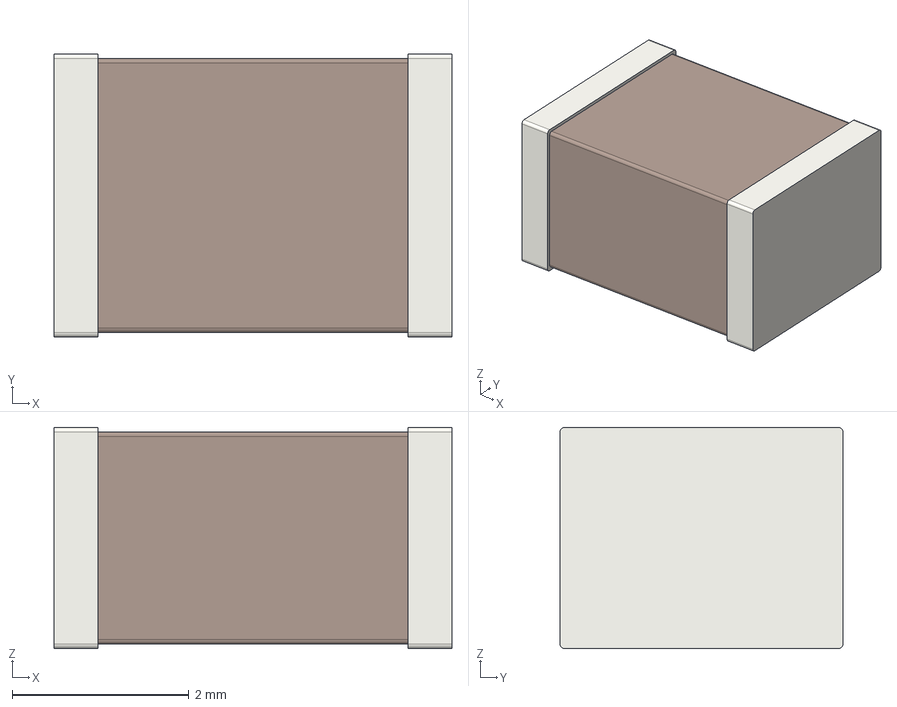
[picture p58: CAD file, 2025-07-09]
JRIX Capacitor SMD 3D Models/C_1812_4532Metric.step
4.50 x 3.20 x 2.50 mm
