JOCRIX/JRIX-KiCad-Schematic-symbols-and-Footprint-libraries/JRIX Capacitor SMD 3D Models/CP_Elec_6.3x9.9.step

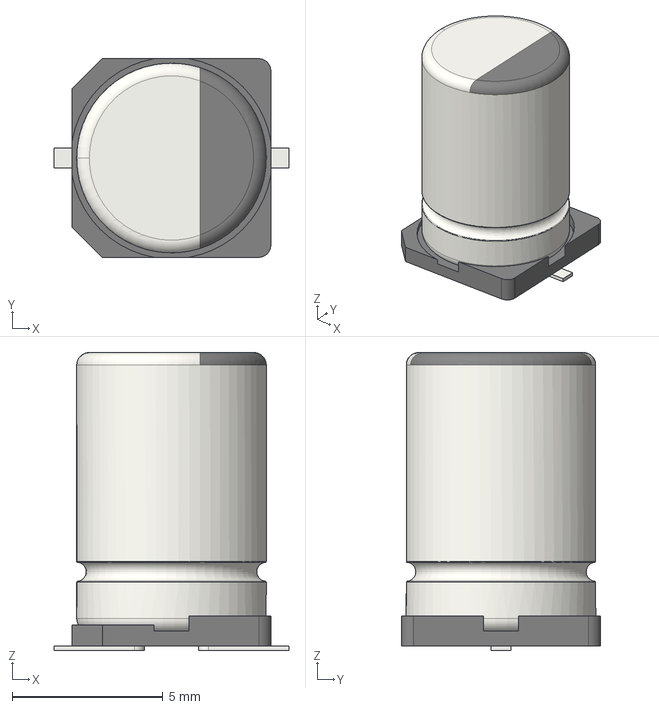
[picture p59: CAD file, 2025-07-09]
JRIX Capacitor SMD 3D Models/CP_Elec_6.3x9.9.step
7.80 x 6.60 x 9.90 mm
