JOCRIX/JRIX-KiCad-Schematic-symbols-and-Footprint-libraries/JRIX Capacitor SMD 3D Models/C_Trimmer_Voltronics_JZ.step

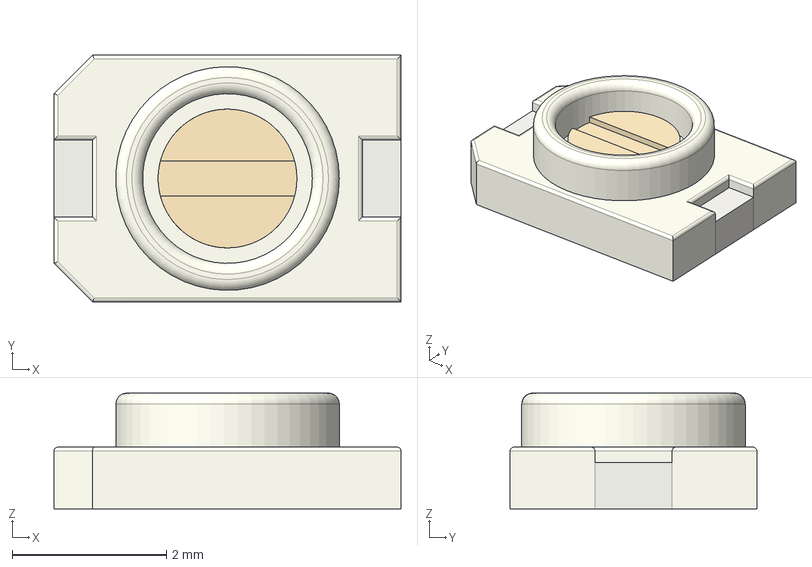
[picture p60: CAD file, 2025-07-09]
JRIX Capacitor SMD 3D Models/C_Trimmer_Voltronics_JZ.step
4.50 x 3.20 x 1.50 mm
