JOCRIX/JRIX-KiCad-Schematic-symbols-and-Footprint-libraries/JRIX Capacitor SMD 3D Models/C_2512_6332Metric.step

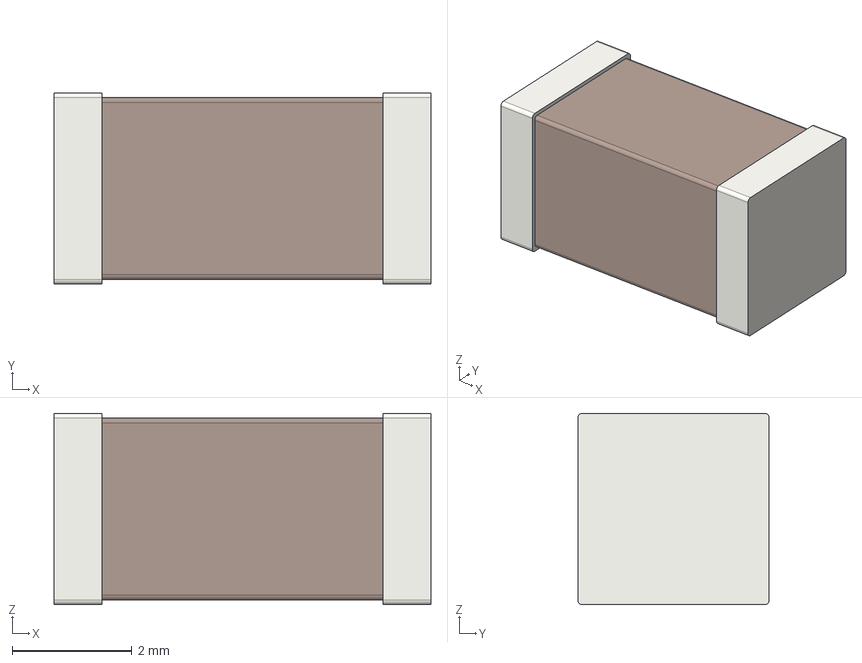
[picture p61: CAD file, 2025-07-09]
JRIX Capacitor SMD 3D Models/C_2512_6332Metric.step
6.30 x 3.20 x 3.20 mm
