JOCRIX/JRIX-KiCad-Schematic-symbols-and-Footprint-libraries/JRIX Capacitor SMD 3D Models/CP_Elec_8x6.2.step

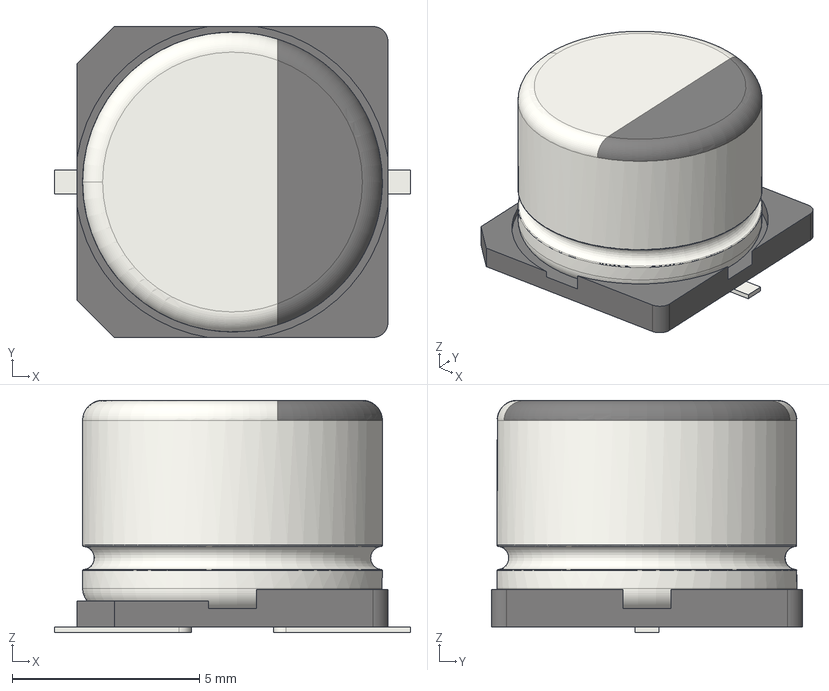
[picture p63: CAD file, 2025-07-09]
JRIX Capacitor SMD 3D Models/CP_Elec_8x6.2.step
9.50 x 8.30 x 6.20 mm
