JOCRIX/JRIX-KiCad-Schematic-symbols-and-Footprint-libraries/JRIX Capacitor SMD 3D Models/C_Trimmer_Murata_TZC3.step

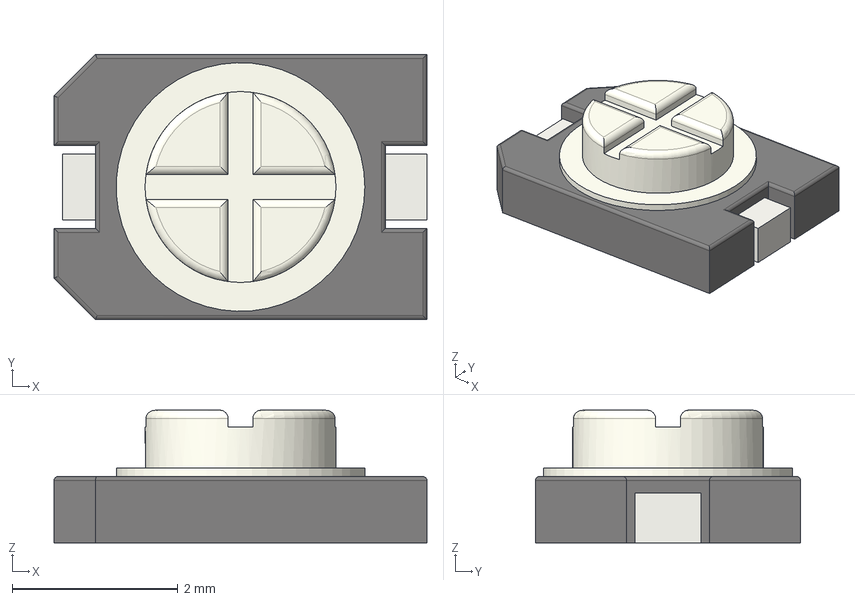
[picture p64: CAD file, 2025-07-09]
JRIX Capacitor SMD 3D Models/C_Trimmer_Murata_TZC3.step
4.50 x 3.20 x 1.60 mm
