JOCRIX/JRIX-KiCad-Schematic-symbols-and-Footprint-libraries/JRIX Capacitor SMD 3D Models/C_0402_1005Metric.step

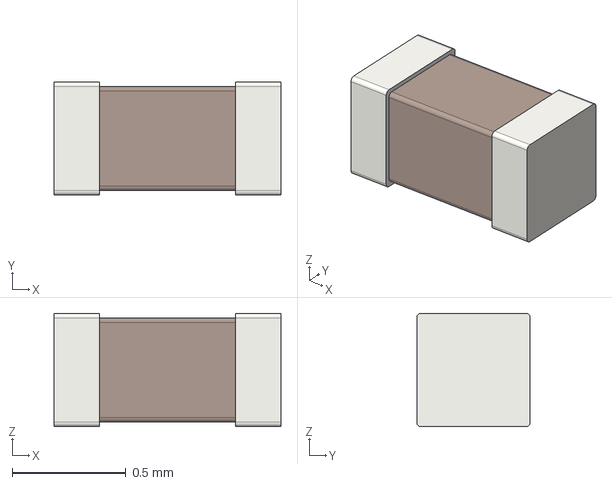
[picture p66: CAD file, 2025-07-09]
JRIX Capacitor SMD 3D Models/C_0402_1005Metric.step
1.00 x 0.5 x 0.5 mm
