JOCRIX/JRIX-KiCad-Schematic-symbols-and-Footprint-libraries/JRIX Capacitor SMD 3D Models/C_Trimmer_Voltronics_JV.step

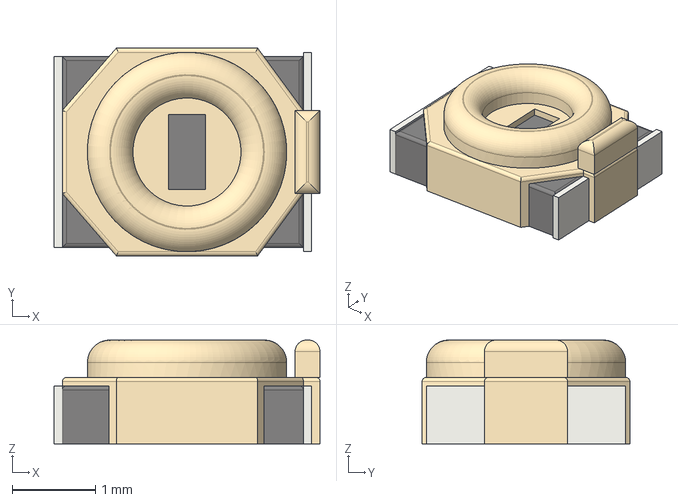
[picture p67: CAD file, 2025-07-09]
JRIX Capacitor SMD 3D Models/C_Trimmer_Voltronics_JV.step
3.20 x 2.50 x 1.25 mm
