JOCRIX/JRIX-KiCad-Schematic-symbols-and-Footprint-libraries/JRIX Capacitor SMD 3D Models/C_Trimmer_Murata_TZW4.step

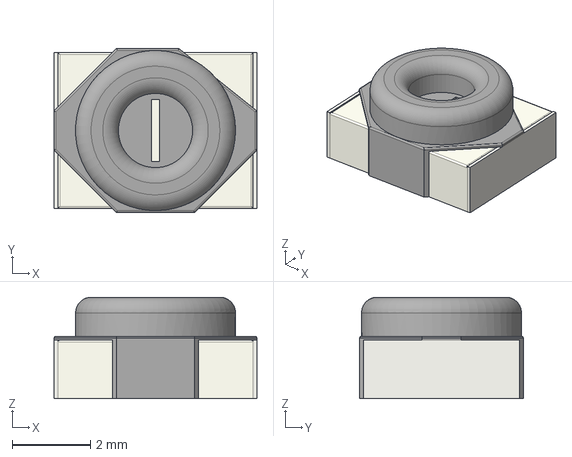
[picture p68: CAD file, 2025-07-09]
JRIX Capacitor SMD 3D Models/C_Trimmer_Murata_TZW4.step
5.20 x 4.20 x 2.60 mm
