JOCRIX/JRIX-KiCad-Schematic-symbols-and-Footprint-libraries/JRIX Capacitor SMD 3D Models/C_Elec_4x5.4.step

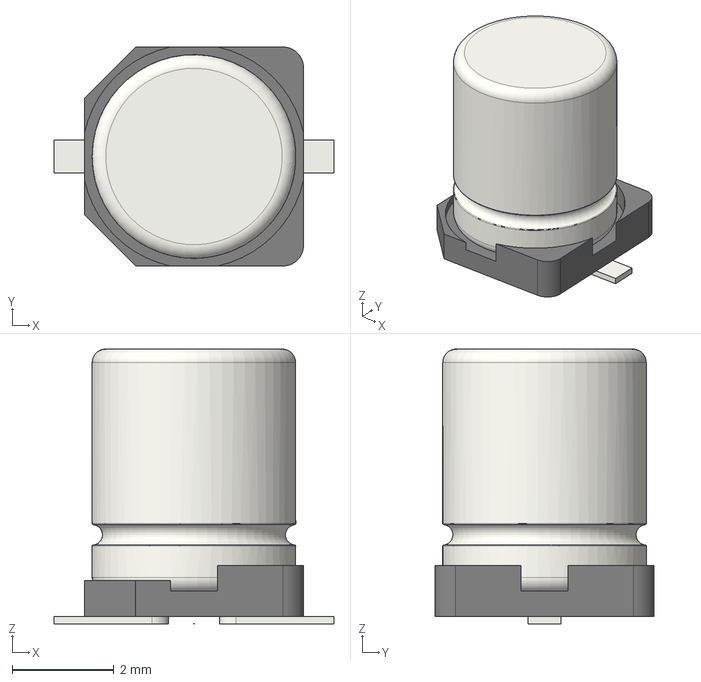
[picture p69: CAD file, 2025-07-09]
JRIX Capacitor SMD 3D Models/C_Elec_4x5.4.step
5.50 x 4.30 x 5.40 mm
