JOCRIX/JRIX-KiCad-Schematic-symbols-and-Footprint-libraries/JRIX Capacitor SMD 3D Models/C_Elec_10x10.2.step

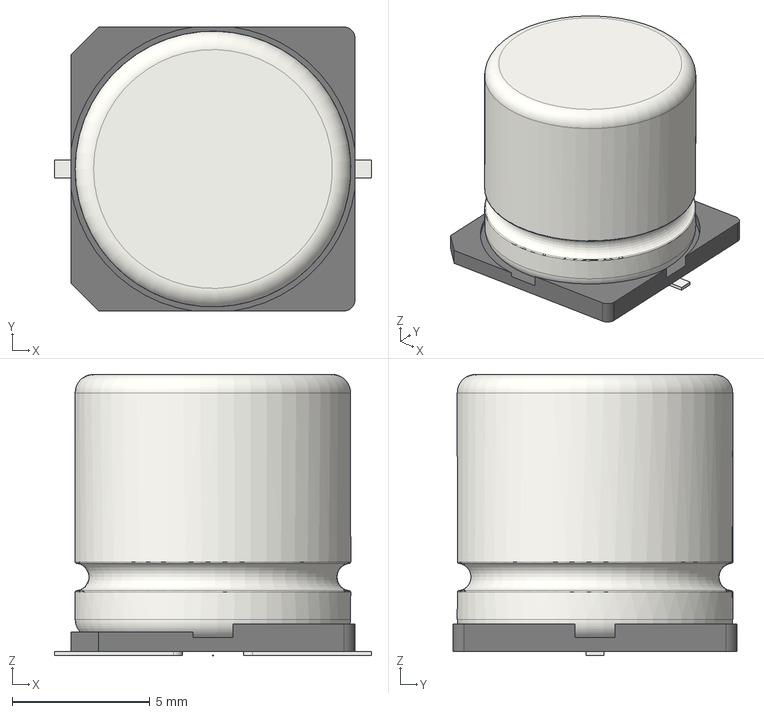
[picture p72: CAD file, 2025-07-09]
JRIX Capacitor SMD 3D Models/C_Elec_10x10.2.step
11.5 x 10.3 x 10.2 mm
