JOCRIX/JRIX-KiCad-Schematic-symbols-and-Footprint-libraries/JRIX Capacitor SMD 3D Models/C_0603_1608Metric.step

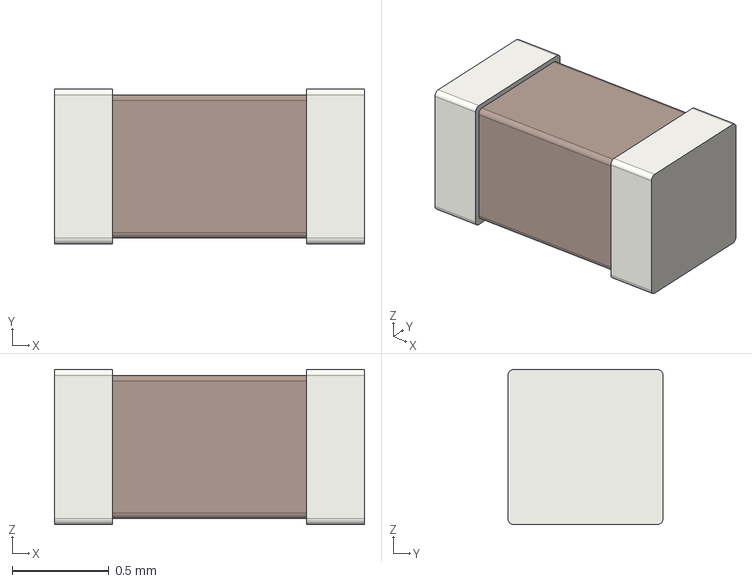
[picture p73: CAD file, 2025-07-09]
JRIX Capacitor SMD 3D Models/C_0603_1608Metric.step
1.60 x 0.8 x 0.8 mm
