JOCRIX/JRIX-KiCad-Schematic-symbols-and-Footprint-libraries/JRIX Capacitor SMD 3D Models/C_Elec_8x10.2.step

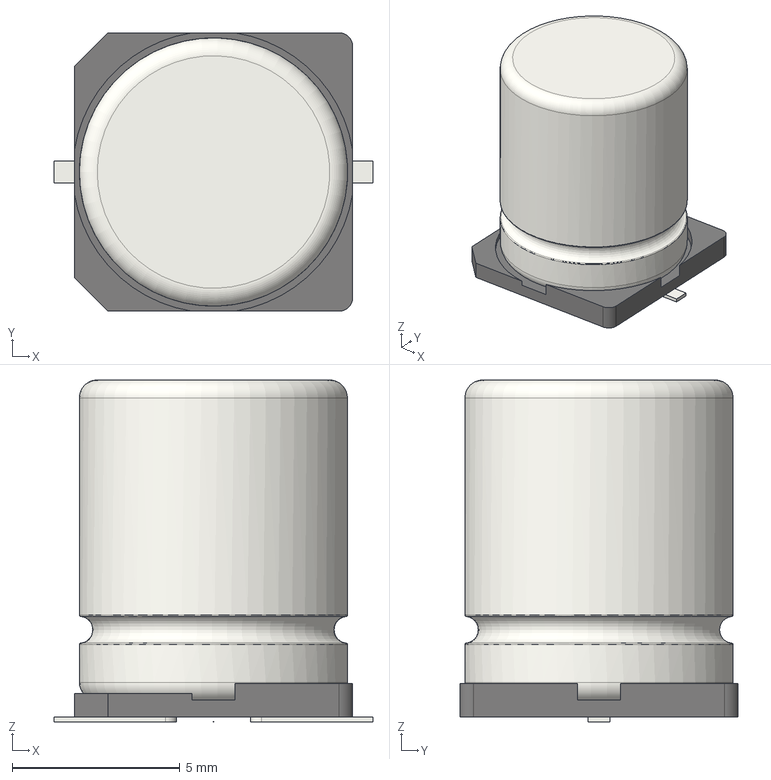
[picture p74: CAD file, 2025-07-09]
JRIX Capacitor SMD 3D Models/C_Elec_8x10.2.step
9.50 x 8.30 x 10.2 mm
