JOCRIX/JRIX-KiCad-Schematic-symbols-and-Footprint-libraries/JRIX Capacitor SMD 3D Models/CP_Elec_16x22.step

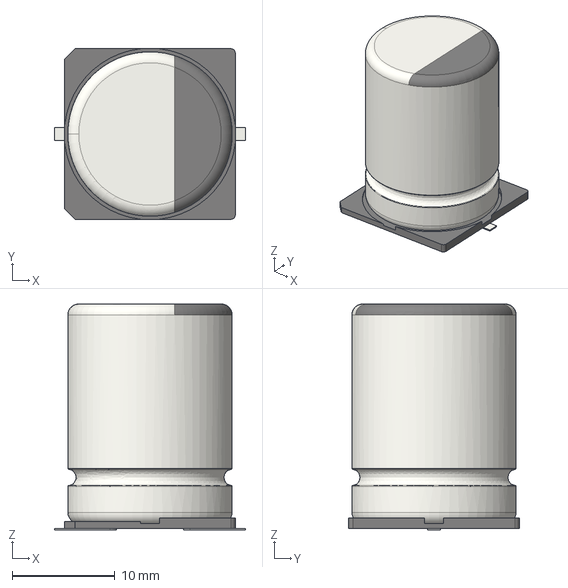
[picture p75: CAD file, 2025-07-09]
JRIX Capacitor SMD 3D Models/CP_Elec_16x22.step
18.6 x 16.6 x 22.0 mm
