JOCRIX/JRIX-KiCad-Schematic-symbols-and-Footprint-libraries/JRIX Capacitor SMD 3D Models/C_0805_2012Metric.step

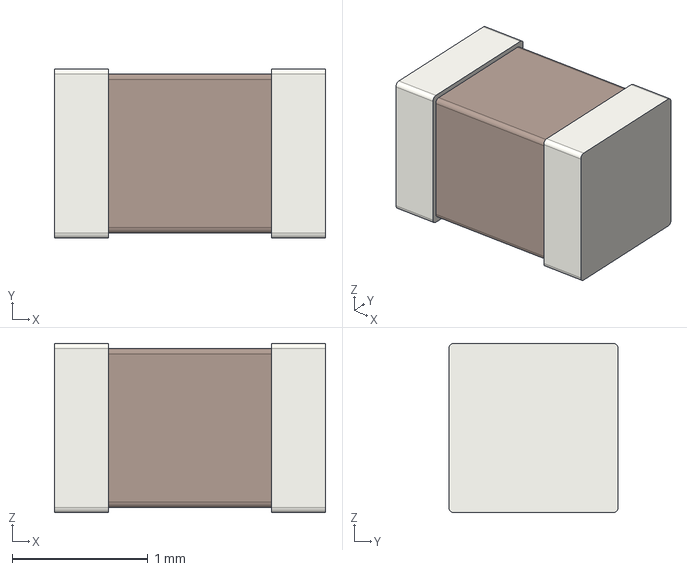
[picture p76: CAD file, 2025-07-09]
JRIX Capacitor SMD 3D Models/C_0805_2012Metric.step
2.00 x 1.25 x 1.25 mm
