JOCRIX/JRIX-KiCad-Schematic-symbols-and-Footprint-libraries/JRIX Capacitor SMD 3D Models/C_01005_0402Metric.step

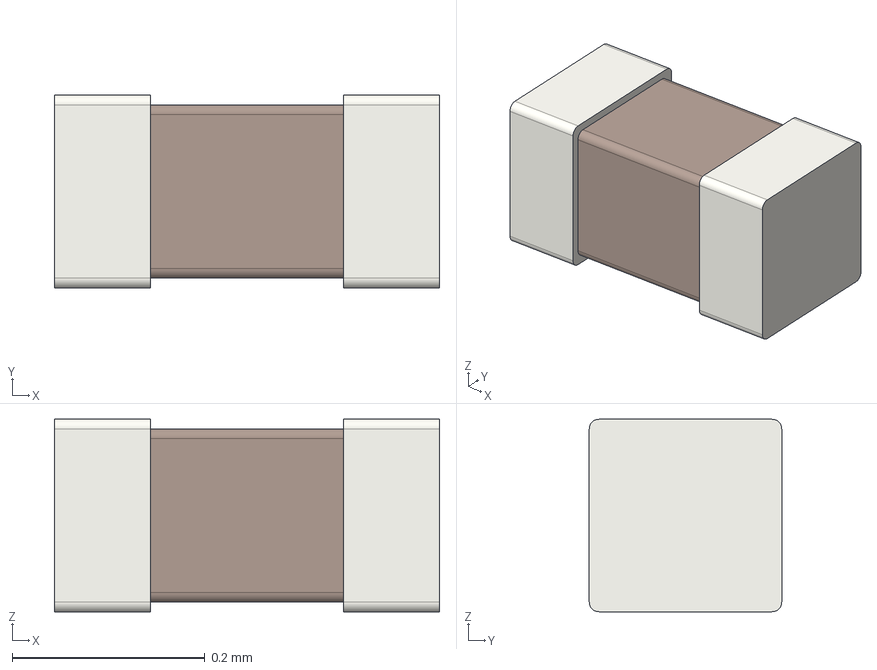
[picture p78: CAD file, 2025-07-09]
JRIX Capacitor SMD 3D Models/C_01005_0402Metric.step
0.4 x 0.2 x 0.2 mm
