JOCRIX/JRIX-KiCad-Schematic-symbols-and-Footprint-libraries/JRIX Capacitor SMD 3D Models/C_0201_0603Metric.step

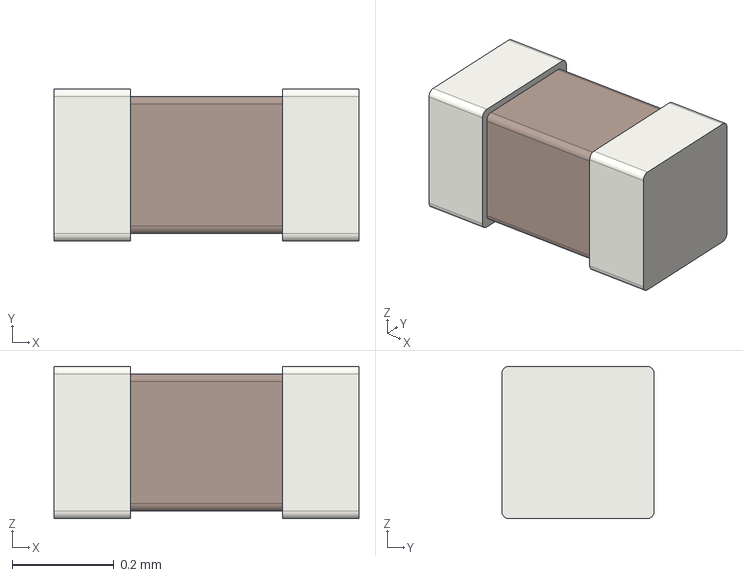
[picture p79: CAD file, 2025-07-09]
JRIX Capacitor SMD 3D Models/C_0201_0603Metric.step
0.6 x 0.3 x 0.3 mm
