JOCRIX/JRIX-KiCad-Schematic-symbols-and-Footprint-libraries/JRIX Capacitor SMD 3D Models/C_Elec_6.3x5.8.step

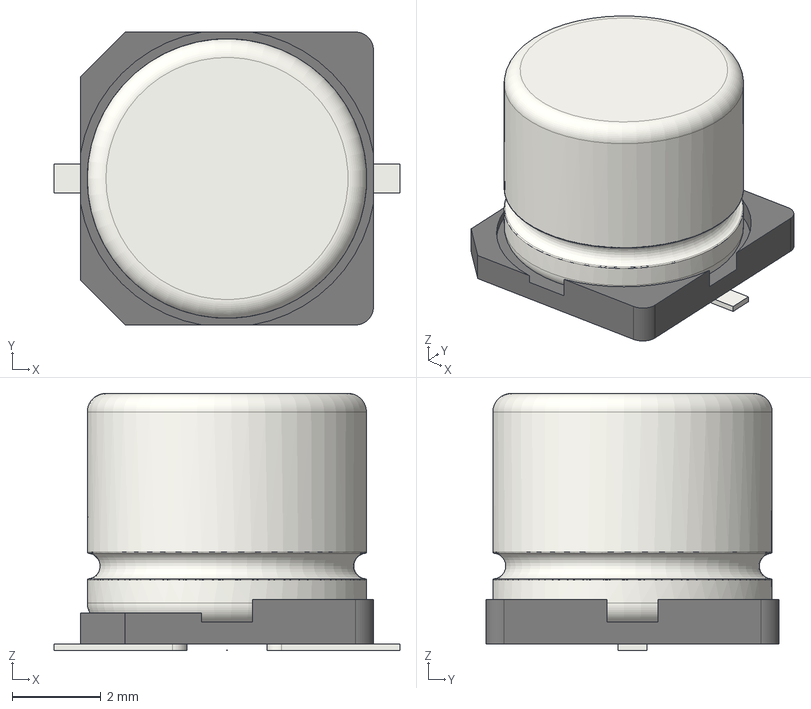
[picture p80: CAD file, 2025-07-09]
JRIX Capacitor SMD 3D Models/C_Elec_6.3x5.8.step
7.80 x 6.60 x 5.80 mm
