JOCRIX/JRIX-KiCad-Schematic-symbols-and-Footprint-libraries/JRIX Capacitor SMD 3D Models/CP_Elec_10x14.3.step

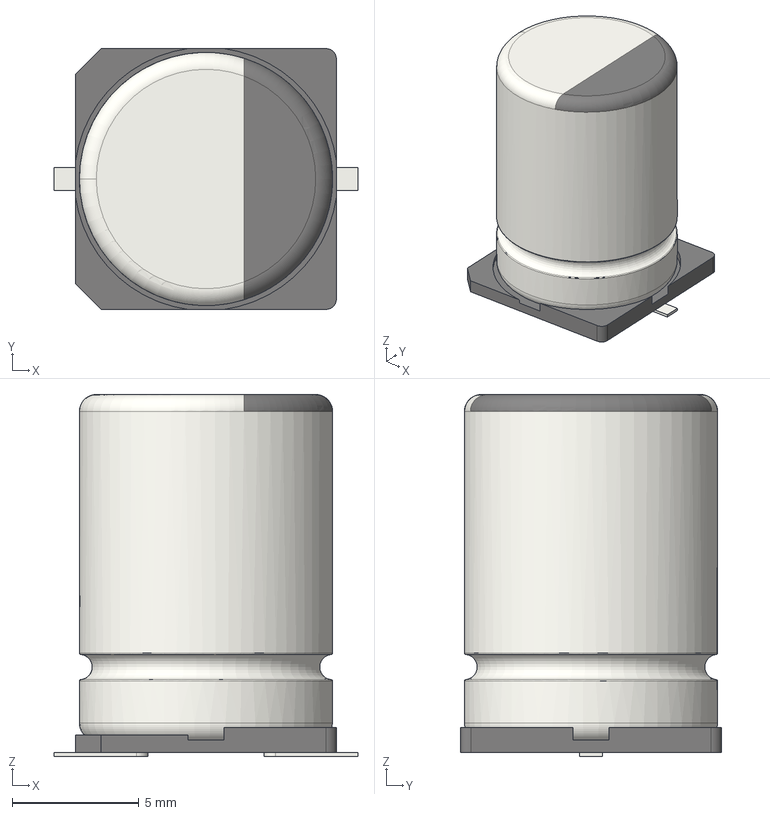
[picture p81: CAD file, 2025-07-09]
JRIX Capacitor SMD 3D Models/CP_Elec_10x14.3.step
12.0 x 10.3 x 14.3 mm
