JOCRIX/JRIX-KiCad-Schematic-symbols-and-Footprint-libraries/JRIX Capacitor SMD 3D Models/C_1206_3216Metric.step

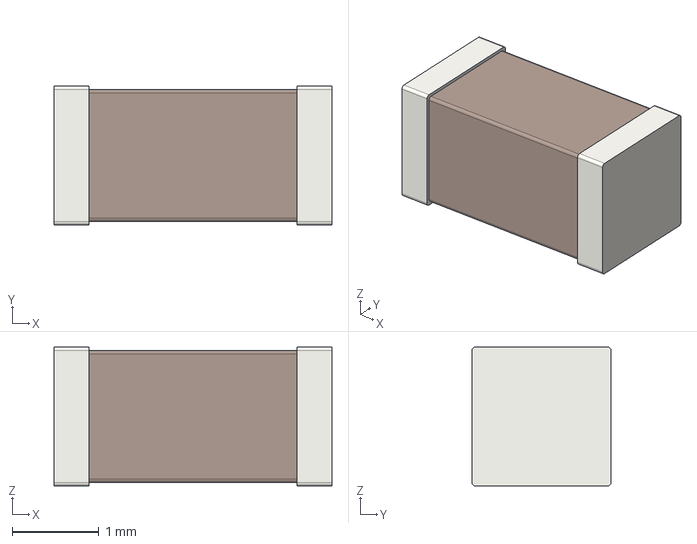
[picture p83: CAD file, 2025-07-09]
JRIX Capacitor SMD 3D Models/C_1206_3216Metric.step
3.20 x 1.60 x 1.60 mm
