JOCRIX/JRIX-KiCad-Schematic-symbols-and-Footprint-libraries/JRIX Capacitor SMD 3D Models/C_1825_4564Metric.step

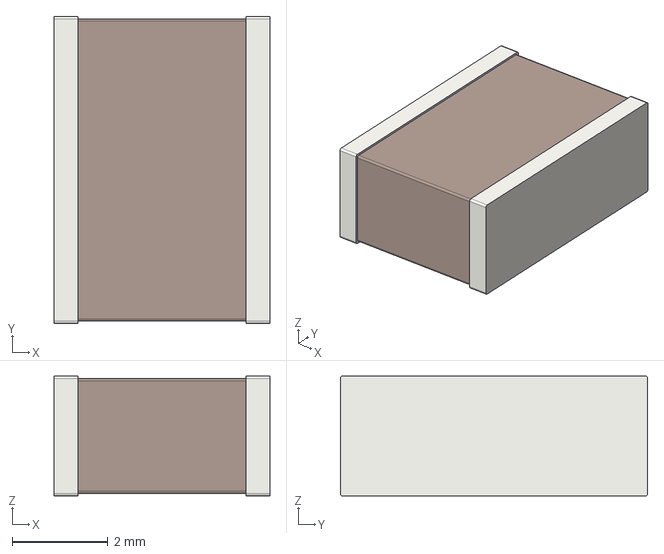
[picture p84: CAD file, 2025-07-09]
JRIX Capacitor SMD 3D Models/C_1825_4564Metric.step
4.50 x 6.40 x 2.50 mm
