JOCRIX/JRIX-KiCad-Schematic-symbols-and-Footprint-libraries/JRIX Capacitor SMD 3D Models/C_Trimmer_Voltronics_JQ.step

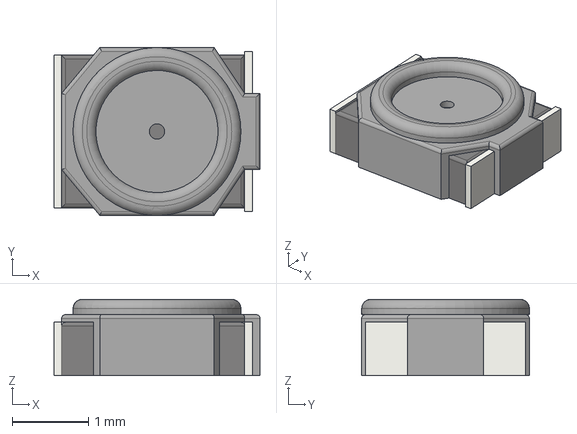
[picture p85: CAD file, 2025-07-09]
JRIX Capacitor SMD 3D Models/C_Trimmer_Voltronics_JQ.step
2.70 x 2.20 x 1.00 mm
