JOCRIX/JRIX-KiCad-Schematic-symbols-and-Footprint-libraries/JRIX Capacitor SMD 3D Models/C_2010_5025Metric.step

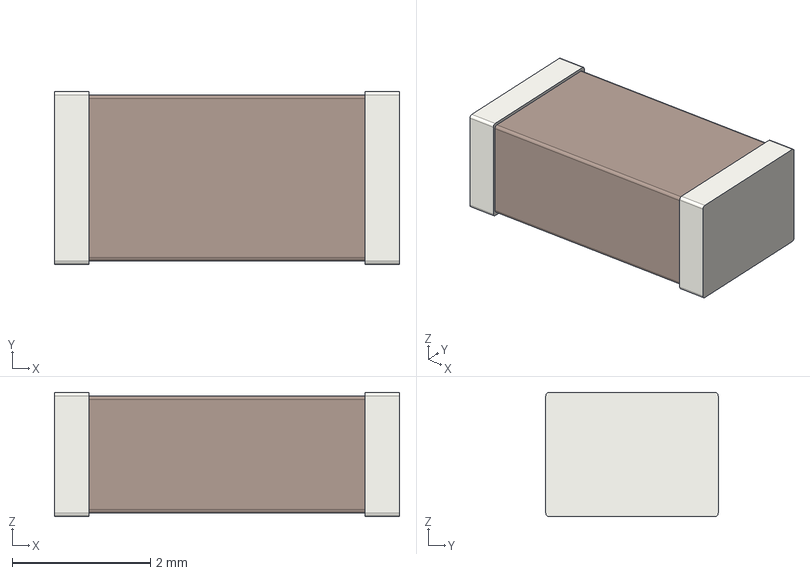
[picture p87: CAD file, 2025-07-09]
JRIX Capacitor SMD 3D Models/C_2010_5025Metric.step
5.00 x 2.50 x 1.80 mm
