JOCRIX/JRIX-KiCad-Schematic-symbols-and-Footprint-libraries/JRIX Capacitor SMD 3D Models/C_2816_7142Metric.step

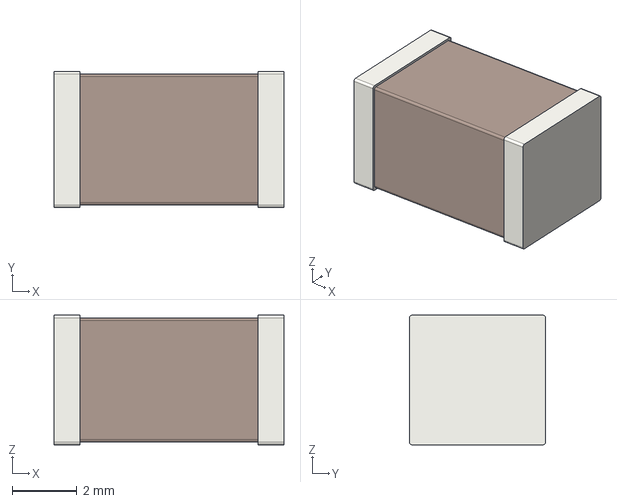
[picture p88: CAD file, 2025-07-09]
JRIX Capacitor SMD 3D Models/C_2816_7142Metric.step
7.10 x 4.20 x 4.00 mm
