JOCRIX/JRIX-KiCad-Schematic-symbols-and-Footprint-libraries/JRIX Capacitor SMD 3D Models/CP_Elec_18x17.5.step

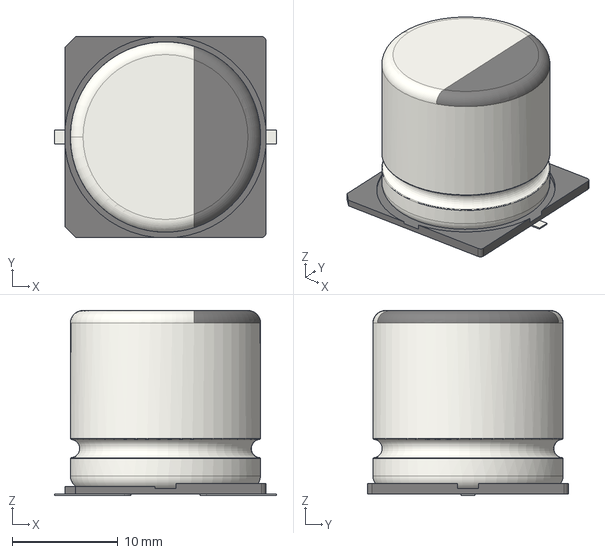
[picture p89: CAD file, 2025-07-09]
JRIX Capacitor SMD 3D Models/CP_Elec_18x17.5.step
21.0 x 19.0 x 17.5 mm
