JOCRIX/JRIX-KiCad-Schematic-symbols-and-Footprint-libraries/JRIX Capacitor SMD 3D Models/CP_Elec_4x5.3.step

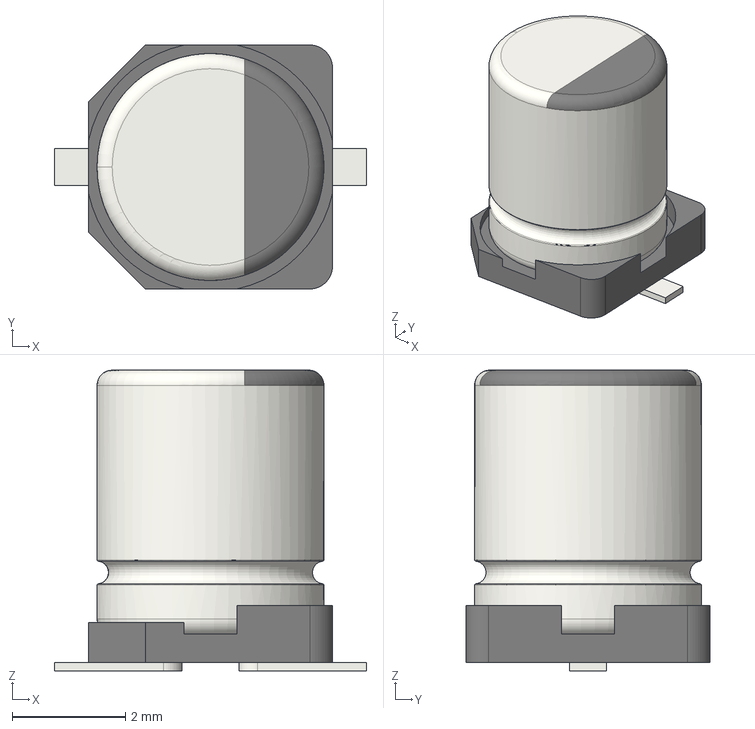
[picture p90: CAD file, 2025-07-09]
JRIX Capacitor SMD 3D Models/CP_Elec_4x5.3.step
5.50 x 4.30 x 5.30 mm
