JOCRIX/JRIX-KiCad-Schematic-symbols-and-Footprint-libraries/JRIX Capacitor SMD 3D Models/CP_Elec_16x17.5.step

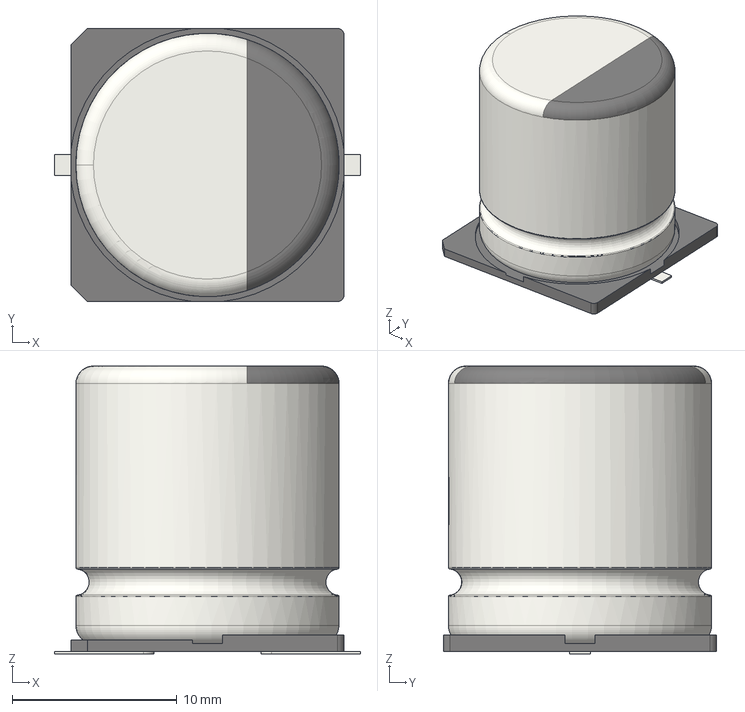
[picture p91: CAD file, 2025-07-09]
JRIX Capacitor SMD 3D Models/CP_Elec_16x17.5.step
18.6 x 16.6 x 17.5 mm
