JOCRIX/JRIX-KiCad-Schematic-symbols-and-Footprint-libraries/JRIX Capacitor SMD 3D Models/C_Trimmer_Voltronics_JN.step

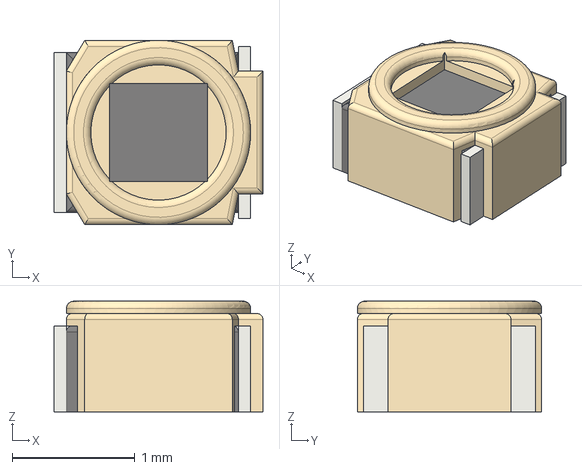
[picture p93: CAD file, 2025-07-09]
JRIX Capacitor SMD 3D Models/C_Trimmer_Voltronics_JN.step
1.70 x 1.50 x 0.9 mm
