JOCRIX/JRIX-KiCad-Schematic-symbols-and-Footprint-libraries/JRIX Capacitor SMD 3D Models/CP_Elec_10x10.5.step

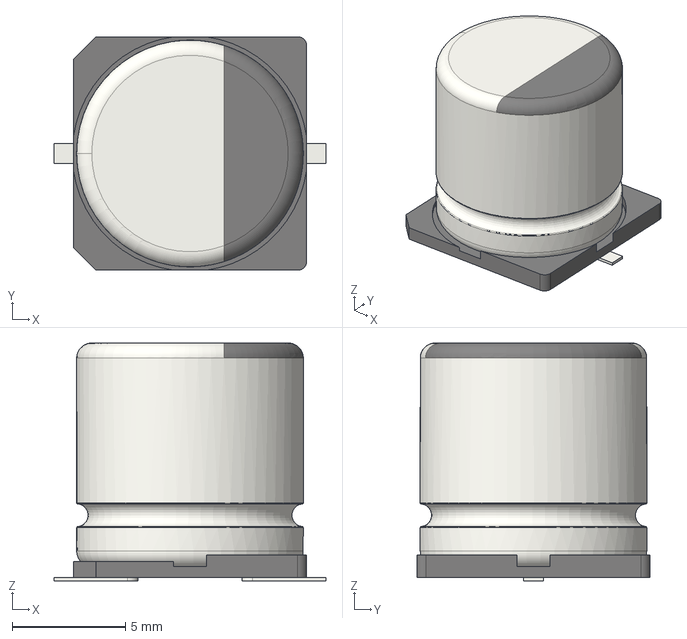
[picture p95: CAD file, 2025-07-09]
JRIX Capacitor SMD 3D Models/CP_Elec_10x10.5.step
12.0 x 10.3 x 10.5 mm
