JOCRIX/JRIX-KiCad-Schematic-symbols-and-Footprint-libraries/JRIX Capacitor SMD 3D Models/C_Elec_5x5.4.step

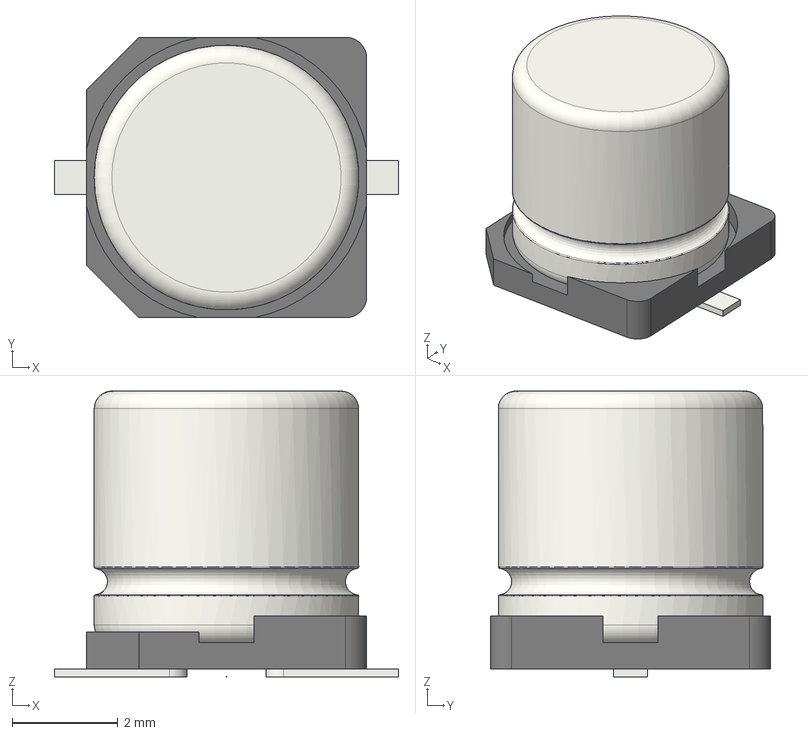
[picture p98: CAD file, 2025-07-09]
JRIX Capacitor SMD 3D Models/C_Elec_5x5.4.step
6.50 x 5.30 x 5.40 mm
