JOCRIX/JRIX-KiCad-Schematic-symbols-and-Footprint-libraries/JRIX Capacitor SMD 3D Models/CP_Elec_10x12.6.step

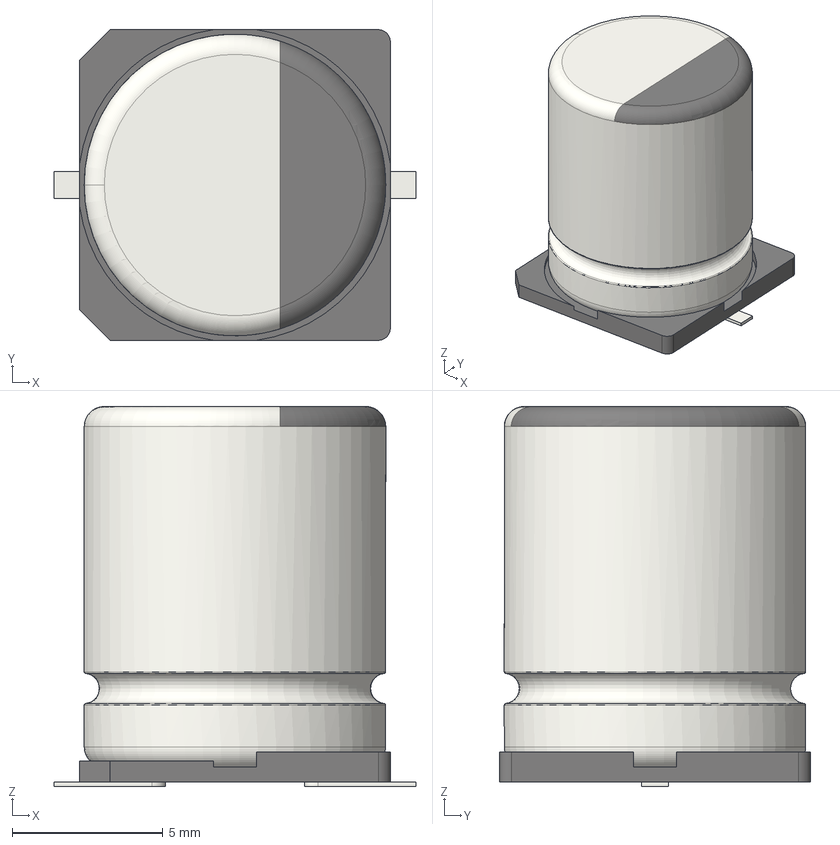
[picture p99: CAD file, 2025-07-09]
JRIX Capacitor SMD 3D Models/CP_Elec_10x12.6.step
12.0 x 10.3 x 12.6 mm
