JOCRIX/JRIX-KiCad-Schematic-symbols-and-Footprint-libraries/JRIX Capacitor SMD 3D Models/C_Trimmer_Sprague-Goodman_SGC3.step

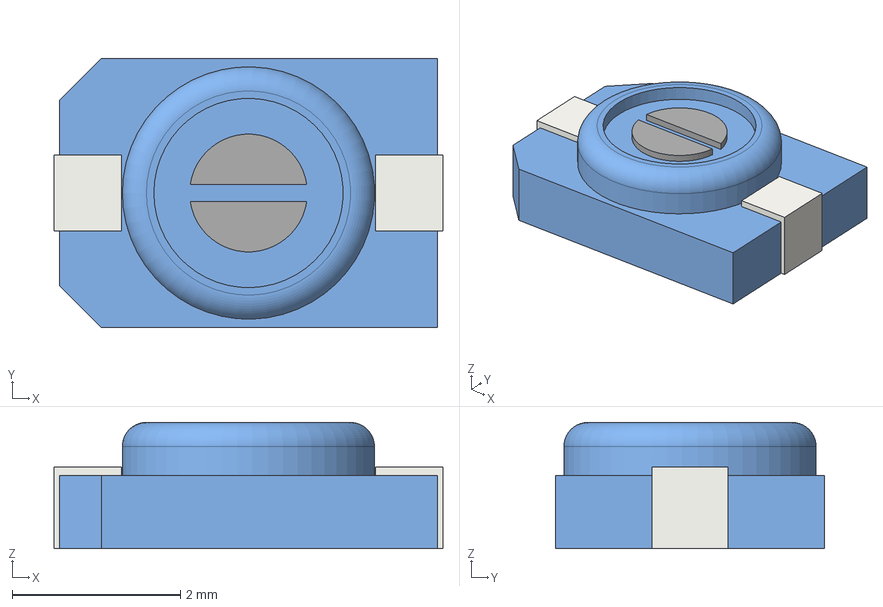
[picture p101: CAD file, 2025-07-09]
JRIX Capacitor SMD 3D Models/C_Trimmer_Sprague-Goodman_SGC3.step
4.62 x 3.20 x 1.50 mm
