JOCRIX/JRIX-KiCad-Schematic-symbols-and-Footprint-libraries/JRIX Capacitor SMD 3D Models/C_1806_4516Metric.step

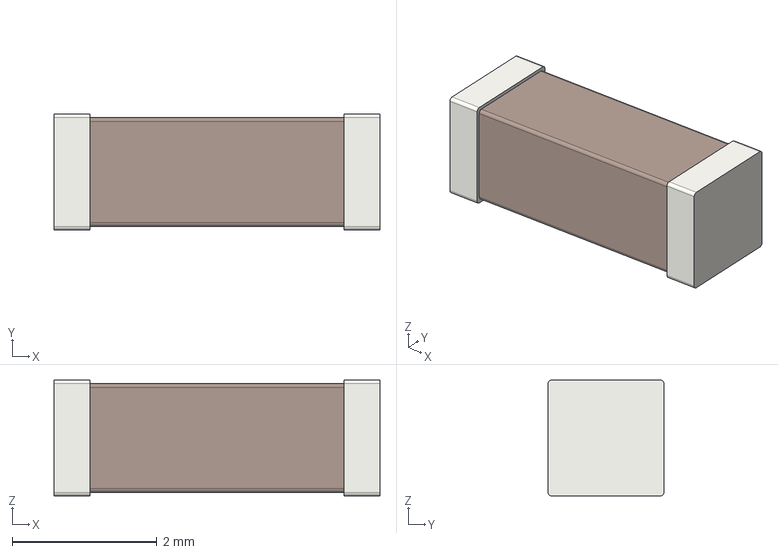
[picture p102: CAD file, 2025-07-09]
JRIX Capacitor SMD 3D Models/C_1806_4516Metric.step
4.50 x 1.60 x 1.60 mm
