JOCRIX/JRIX-KiCad-Schematic-symbols-and-Footprint-libraries/JRIX Capacitor SMD 3D Models/CP_Elec_8x11.9.step

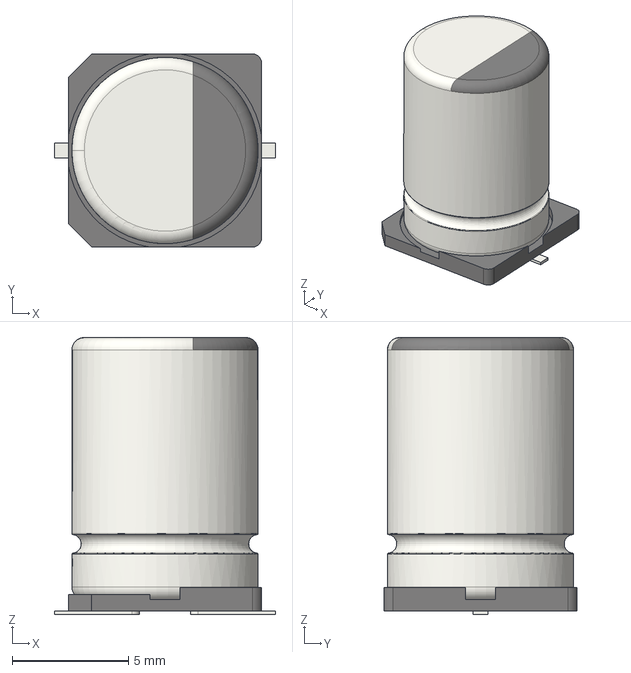
[picture p104: CAD file, 2025-07-09]
JRIX Capacitor SMD 3D Models/CP_Elec_8x11.9.step
9.50 x 8.30 x 11.9 mm
