JOCRIX/JRIX-KiCad-Schematic-symbols-and-Footprint-libraries/JRIX Capacitor SMD 3D Models/C_3640_9110Metric.step

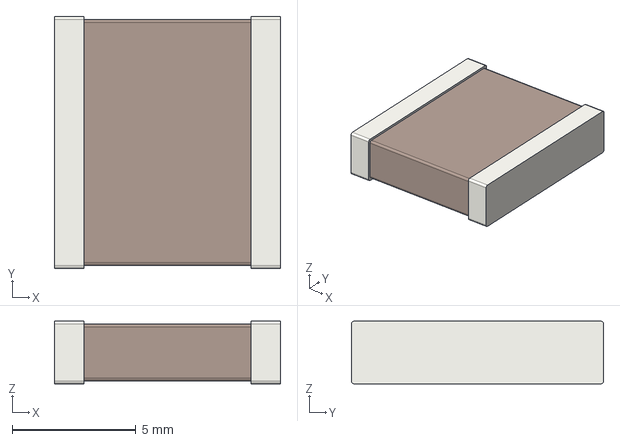
[picture p106: CAD file, 2025-07-09]
JRIX Capacitor SMD 3D Models/C_3640_9110Metric.step
9.14 x 10.2 x 2.54 mm
