JOCRIX/JRIX-KiCad-Schematic-symbols-and-Footprint-libraries/JRIX Capacitor SMD 3D Models/CP_Elec_5x5.8.step

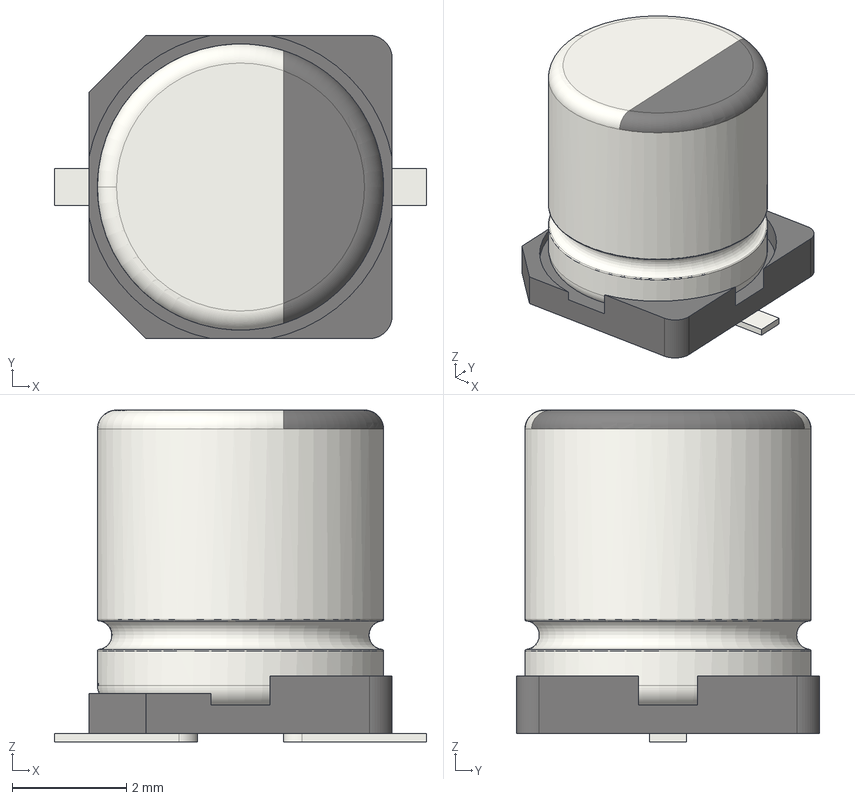
[picture p107: CAD file, 2025-07-09]
JRIX Capacitor SMD 3D Models/CP_Elec_5x5.8.step
6.50 x 5.30 x 5.80 mm
