JOCRIX/JRIX-KiCad-Schematic-symbols-and-Footprint-libraries/JRIX Capacitor SMD 3D Models/C_1210_3225Metric.step

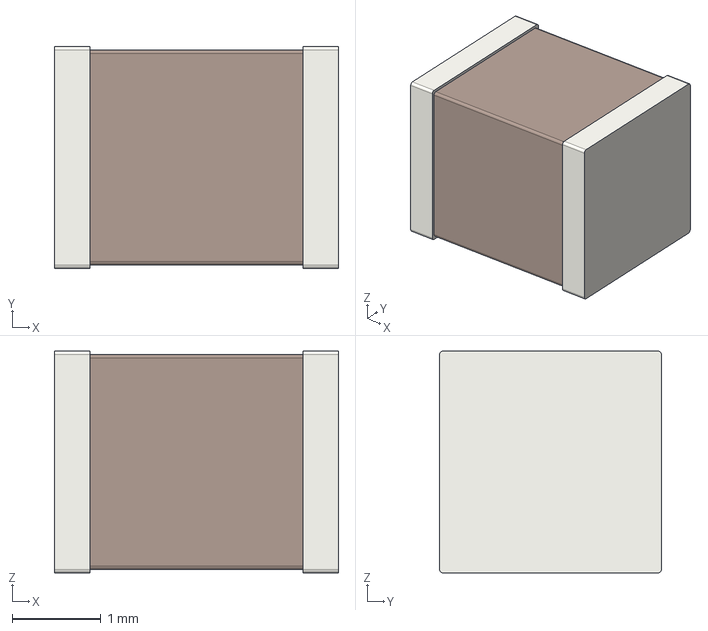
[picture p108: CAD file, 2025-07-09]
JRIX Capacitor SMD 3D Models/C_1210_3225Metric.step
3.20 x 2.50 x 2.50 mm
