JOCRIX/JRIX-KiCad-Schematic-symbols-and-Footprint-libraries/JRIX Capacitor SMD 3D Models/C_1808_4520Metric.step

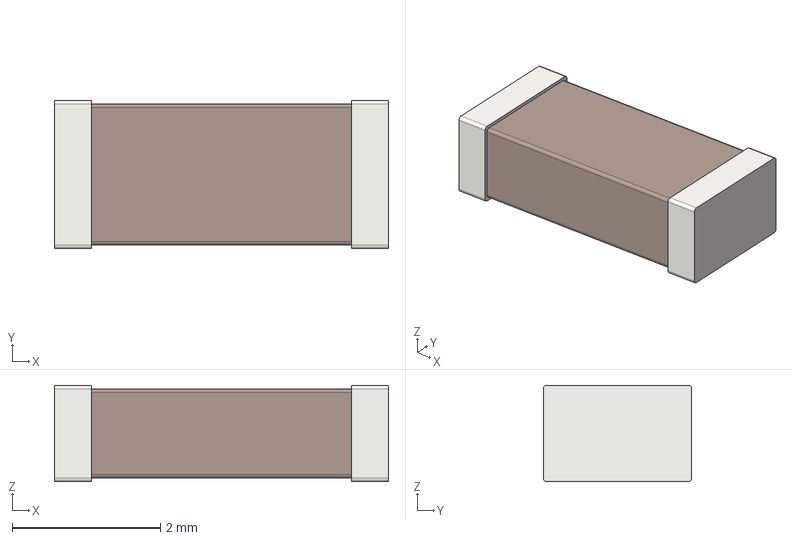
[picture p110: CAD file, 2025-07-09]
JRIX Capacitor SMD 3D Models/C_1808_4520Metric.step
4.50 x 2.00 x 1.30 mm
