JOCRIX/JRIX-KiCad-Schematic-symbols-and-Footprint-libraries/JRIX Capacitor SMD 3D Models/C_Trimmer_Murata_TZR1.step

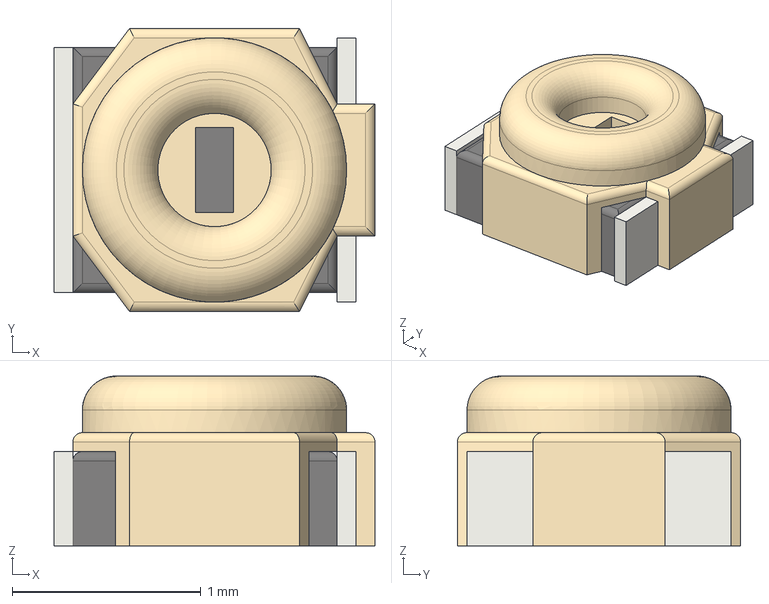
[picture p111: CAD file, 2025-07-09]
JRIX Capacitor SMD 3D Models/C_Trimmer_Murata_TZR1.step
1.70 x 1.50 x 0.9 mm
