JOCRIX/JRIX-KiCad-Schematic-symbols-and-Footprint-libraries/JRIX Capacitor SMD 3D Models/CP_Elec_6.3x5.7.step

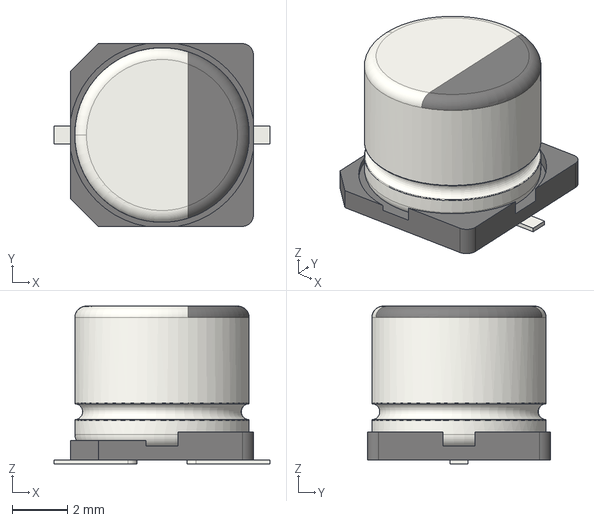
[picture p112: CAD file, 2025-07-09]
JRIX Capacitor SMD 3D Models/CP_Elec_6.3x5.7.step
7.80 x 6.60 x 5.70 mm
