JOCRIX/JRIX-KiCad-Schematic-symbols-and-Footprint-libraries/JRIX Capacitor SMD 3D Models/C_Trimmer_Murata_TZB4-B.step

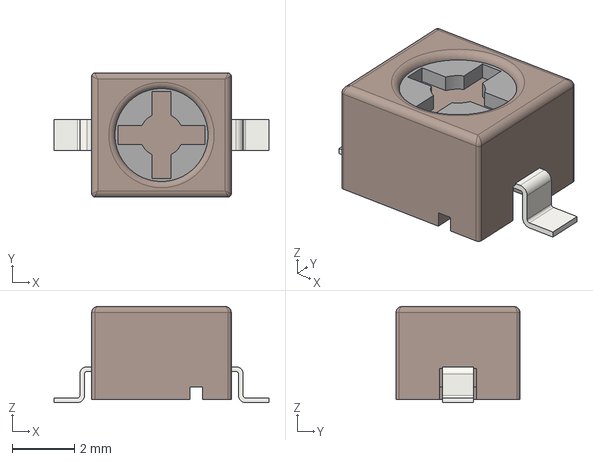
[picture p113: CAD file, 2025-07-09]
JRIX Capacitor SMD 3D Models/C_Trimmer_Murata_TZB4-B.step
6.93 x 4.00 x 3.10 mm
