JOCRIX/JRIX-KiCad-Schematic-symbols-and-Footprint-libraries/JRIX Capacitor SMD 3D Models/C_2220_5750Metric.step

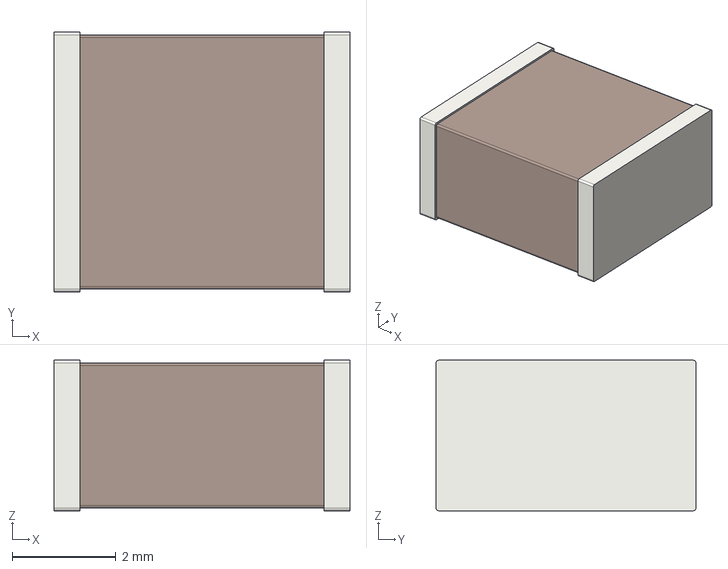
[picture p114: CAD file, 2025-07-09]
JRIX Capacitor SMD 3D Models/C_2220_5750Metric.step
5.70 x 5.00 x 2.90 mm
