JOCRIX/JRIX-KiCad-Schematic-symbols-and-Footprint-libraries/JRIX Capacitor SMD 3D Models/C_2225_5664Metric.step

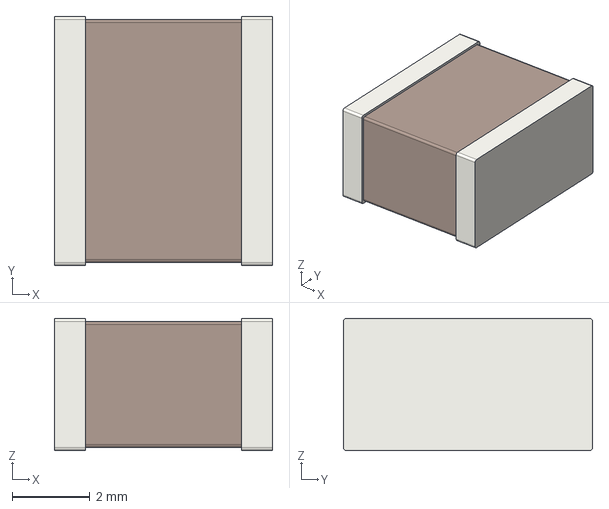
[picture p117: CAD file, 2025-07-09]
JRIX Capacitor SMD 3D Models/C_2225_5664Metric.step
5.60 x 6.40 x 3.40 mm
