JOCRIX/JRIX-KiCad-Schematic-symbols-and-Footprint-libraries/JRIX Capacitor SMD 3D Models/C_Trimmer_Murata_TZB4-A.step

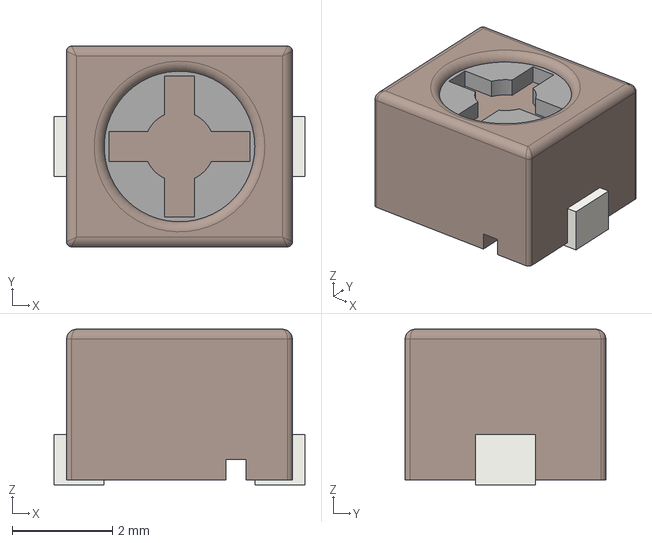
[picture p118: CAD file, 2025-07-09]
JRIX Capacitor SMD 3D Models/C_Trimmer_Murata_TZB4-A.step
5.00 x 4.00 x 3.10 mm
