JOCRIX/JRIX-KiCad-Schematic-symbols-and-Footprint-libraries/(list of files, cad)

Other CAD files:
JRIX Ferrite Beat 3D Models/FB_0805_2x1.2x0.9_742792030.stp
JRIX Resistor 3D Models/R_MiniMELF_MMA-0204.step
JRIX Capacitor SMD 3D Models/C_EMF105B7104KVHF.stp
JRIX Capacitor SMD 3D Models/C_Elec_6.3x7.7.step
JRIX Capacitor SMD 3D Models/C_Elec_8x6.2.step
JRIX Capacitor SMD 3D Models/C_Elec_3x5.4.step
JRIX Capacitor SMD 3D Models/CP_Elec_4x5.8.step
JRIX Capacitor SMD 3D Models/CP_Elec_4x5.4.step
JRIX Capacitor SMD 3D Models/C_Trimmer_Murata_TZY2.step
JRIX Capacitor SMD 3D Models/CP_Elec_6.3x5.8.step
JRIX Capacitor SMD 3D Models/CP_Elec_8x5.4.step
JRIX Capacitor SMD 3D Models/CP_Elec_6.3x5.4_Nichicon.step
JRIX Capacitor SMD 3D Models/CP_Elec_5x5.4.step
JRIX Capacitor SMD 3D Models/CP_Elec_8x10.step
JRIX Capacitor SMD 3D Models/C_Elec_5x5.8.step
JRIX Capacitor SMD 3D Models/C_Elec_6.3x5.4.step
JRIX FASTON Connector 3D Models/63849-1.step
