JOCRIX/JRIX-KiCad-Schematic-symbols-and-Footprint-libraries/(commit log)

2023-03-10 Initial release of all my schematic symbols and footprints
2024-12-03 more stuff
    [63849-1.step, AIUR-15-102K.step, RY-12W-K.step]
2025-07-09 Added components
    [C_EMF105B7104KVHF.stp, C_GCM155R72A102KA37J.stp, C_GRM188R60G476ME01J.stp, C_GRM31CR60J107KEA8L.stp, C_GRMJN65C1H104GE01J.stp, FB_0805_2x1.2x0.9_742792030.stp]
2025-07-10 Added inductor
    [L_1008_2.5x2x1.2_CIGW252012TM1R0MLE.stp]
2025-07-11 added more stuff
    [C_GRM158R61A226ME15J.stp, C_GRM188Z71A475KE15D.stp, L_ASPI-4030S-1R0N-T.stp]
2025-07-13 added more components
    [C_GRM155Z71A225KE01D.stp, C_GRM31C5C1E474JE01L.stp, C_IDC_0508_2.03x1.27_W2L14Z225MAT1S.stp, DFN-10_LT3042EDD#PBF.stp, FB_0805_2x1.25x0.85_MPZ2012S221AT000.stp, LTC2270IUP#PBF.stp]
2025-07-24 Added NXU0104
    [XQFN-14_NXU0104BZZ.stp]
2025-07-26 added some SRAM
    [C_Film_3.2x1.6x1.2_1206_MU_13216_RUB.step, C_Film_5.8x5x4_2220_334JBC_AVX.step, FBGA-48_6x10_Layout-6x8_P0.75_AS7CW2M16-10BIN.stp]
2025-07-26 Added MELF resistors. Updated FPGA 3D model
    [R_MELF_0204_3.6x1.4__MMx-precision-series_MMA02040E5002BB300.stp, R_MiniMELF_MMA-0204.step, TFBGA-324_P0.8mm_Body15x15mm.step]
2025-07-28 Added LT3097, AD3551R
    [22-WFDFN-ExposedPad_22DFN_6x3_AnalogDevices.step, VFQFN-32_ExposedPad_CSP_32-LFCSP_5x5.step]
2025-07-28 Added 06035A250GAT2A
    [C_1.6x0.81x0.9_0603_1608_06035A250GAT2A.stp]
2025-07-29 updated fpga symbol
    [C_1x0.5x0.5604023A1R2BAT2A.stp, C_2x1.25x1.25_GRM21BZ71C106KE15K.stp, R_ThinFilm_1x0.5x0.35_0402_TNPW040249K9BYEP.step, SOT-23-5_SC-74A_SOT-753_RJ_5_ADI.step, SSOP-28_5.3x10.2x1.8.iges]
